flyingperson23/Booster-TC/info.txt

comp3 is ocd, sets flag on trigger
comp1 rising edge, resets output sync timer (pwm triggers before new rising edge)
comp2 both edges, resets measure timer (input capture, on interrupt set output sync timer ccr to 2*measure timer ccr - val, set output pwm arr=2*ccr, pulse=ccr)
output pwm timer resets on output sync timer trigger

output pwm = tim8
output sync timer = tim2
input measure timer = tim1

tim3 = lights pwm
comp6 = ac sync
adc1 = therm
tim20 = scr
tim7 = led pulse
tim6 = background loop

adc2, adc4 = vac, i_l
adc5 = vbus
comp7/dac2 = triggers on inductor overcurrent
comp3/dac3 triggers on primary overcurrent

background tasks:
cfg scr/boost
measure therm
set leds

new::
tim1 input capture and pwm
comp1 has no int, just measures + resets
on input capture trigger, measure if comp1 is high or low
if low, we got first half pulse - set pwm arr = 2*measured, ccr = 2*measured-delay
also set output pwm ccr=measured, arr=2*measured
on pwm trigger, hardware reset output and software write gdt disable pins
