flyingperson23/Booster-TC/hardware/booster-tc-driver-v2/booster-tc-driver.csv

Id | Designator | Footprint | Quantity | Designation | Supplier and ref
1 | SW1 | B12JV | 1 | SW_SPDT
2 | U3,U1 | IF-D95 | 2 | IF-D95T << must be T
3 | U2 | IF-E96E | 1 | IF-E96E
4 | J9,J3,J10 | PinHeader_1x2_P2.54mm_Drill1.02mm | 3 | 22-23-2021
5 | J7,J8,J6,J4,J5 | 36471662 | 5 | 3-647166-2
6 | C60,C61 | C_1206_3216Metric_Pad1.33x1.80mm_HandSolder | 2 | 1u C1206C105K5RACTU
7 | C19 | 860020575013 | 1 | 330u 860020575013
8 | C37,C29 | CAPPRD350W52D800H1300 | 2 | 470u 860020474014
9 | U5 | LQFP-48_7x7mm_P0.5mm | 1 | STM32G474CBTx
10 | J11 | CNC_3220-10-0300-00 | 1 | 3220-10-0300-00
11 | D11 | LED_5700100132F | 1 | 5700100132F
12 | U13,U12,U11,U10 | SQJ500AEP-T1_GE3_VIS | 4 | SQJ500AEP-T1_GE3
13 | C59,C58 | C_1210_3225Metric_Pad1.33x2.70mm_HandSolder | 2 | 2u2 C3225X7R1H225K250AB
14 | J2 | SAMTEC_EHT-105-01-S-D | 1 | EHT-105-01-S-D
15 | R29,R28 | R_1210_3225Metric_Pad1.30x2.65mm_HandSolder | 2 | 15R CRCW121015R0JNEAHP
16 | D19,D9,D17,D8,D1,D15,D2,D20,D7,D5,D3,D6,D4,D18,D10 | SOD-123 | 15 | 1N5819HW-7-F
17 | R21,R8,R11,R2,R25,R10,R4,R5,R7,R26,R24,R17,R27,R9,R1 | R_0603_1608Metric_Pad0.98x0.95mm_HandSolder | 15 | 1k
18 | D14 | DO-214AA | 1 | SMBJ3V3
19 | C36,C15,C25,C20,C26,C18,C46,C39,C41,C38,C40,C14,C47,C45,C53,C30,C49,C17,C28,C27,C22,C10,C23,C21,C16,C33,C52,C42 | C_0603_1608Metric_Pad1.08x0.95mm_HandSolder | 28 | .1uf
20 | C12,C11,C24 | C_0603_1608Metric_Pad1.08x0.95mm_HandSolder | 3 | 10n
21 | R16,R15 | R_0603_1608Metric_Pad0.98x0.95mm_HandSolder | 2 | 10k
22 | C9,C6 | C_0603_1608Metric_Pad1.08x0.95mm_HandSolder | 2 | 1u
23 | C55,C57,C54,C56 | C_1206_3216Metric_Pad1.33x1.80mm_HandSolder | 4 | .1uf 885012208087
24 | C34,C43,C51,C44,C50,C35,C4,C48,C1 | C_0603_1608Metric_Pad1.08x0.95mm_HandSolder | 9 | 2u2
25 | U6 | SOT-23 | 1 | MCP9700Ax-ETT
26 | C31,C8,C3,C2 | C_0603_1608Metric_Pad1.08x0.95mm_HandSolder | 4 | 1n
27 | R20 | R_0603_1608Metric_Pad0.98x0.95mm_HandSolder | 1 | 9k
28 | L4 | IND_ACM7060_TDK | 1 | ACM7060-701-2PL-TL01
29 | U7 | TO-263-5_TabPin3 | 1 | AP1501A-12K5G-13
30 | C5,C7 | C_0603_1608Metric_Pad1.08x0.95mm_HandSolder | 2 | 150p
31 | IC4,IC5 | SOIC127P600X175-8N | 2 | UCC27524AQDRQ1
32 | U9 | SOIC-8-1EP_3.9x4.9mm_P1.27mm_EP2.29x3mm | 1 | AOZ1284PI
33 | L2 | LQM2MPN4R7NG0L | 1 | 4u7 LQM2MPN4R7NG0L
34 | R12,R14,R13 | R_0603_1608Metric_Pad0.98x0.95mm_HandSolder | 3 | 24k9
35 | IC1 | CAT4109V-GT2 | 1 | CAT4109V-GT2
36 | R6 | R_2512_6332Metric_Pad1.40x3.35mm_HandSolder | 1 | 2R2 35222R2JT
37 | D16,D12 | D_SOD-128 | 2 | PMEG4050EP
38 | R3 | R_0603_1608Metric_Pad0.98x0.95mm_HandSolder | 1 | 150R
39 | R19 | R_0603_1608Metric_Pad0.98x0.95mm_HandSolder | 1 | 470k
40 | IC2 | SOT230P700X180-4N | 1 | LDL1117S50R
41 | Q1 | SOT-23 | 1 | T2N7002AK
42 | IC3 | SOT65P280X145-8N | 1 | AD5160BRJZ5-RL7
43 | D13 | DO-214AA | 1 | SMBJ5.0A-TR
44 | U4 | CSTNE16M0V530000R0 | 1 | CSTNE8M00G550000R0
45 | R18 | R_0603_1608Metric_Pad0.98x0.95mm_HandSolder | 1 | 47k
46 | R22 | R_0603_1608Metric_Pad0.98x0.95mm_HandSolder | 1 | 3k
47 | R23 | R_0603_1608Metric_Pad0.98x0.95mm_HandSolder | 1 | 82k
48 | C32 | C_0603_1608Metric_Pad1.08x0.95mm_HandSolder | 1 | 22n
49 | L1,L3 | IND_IHLP-3232DZ_VIS-M | 2 | 22u IHLP3232DZER220M5A
50 | U8 | SOT-223-3_TabPin2 | 1 | LT1963AxST-3.3
