flyingperson23/Booster-TC/hardware/booster-tc-driver-v3/booster-tc-driver.kicad_pcb

## KiCad design hardware/booster-tc-driver-v3/booster-tc-driver.kicad_pcb (2025-09-02)

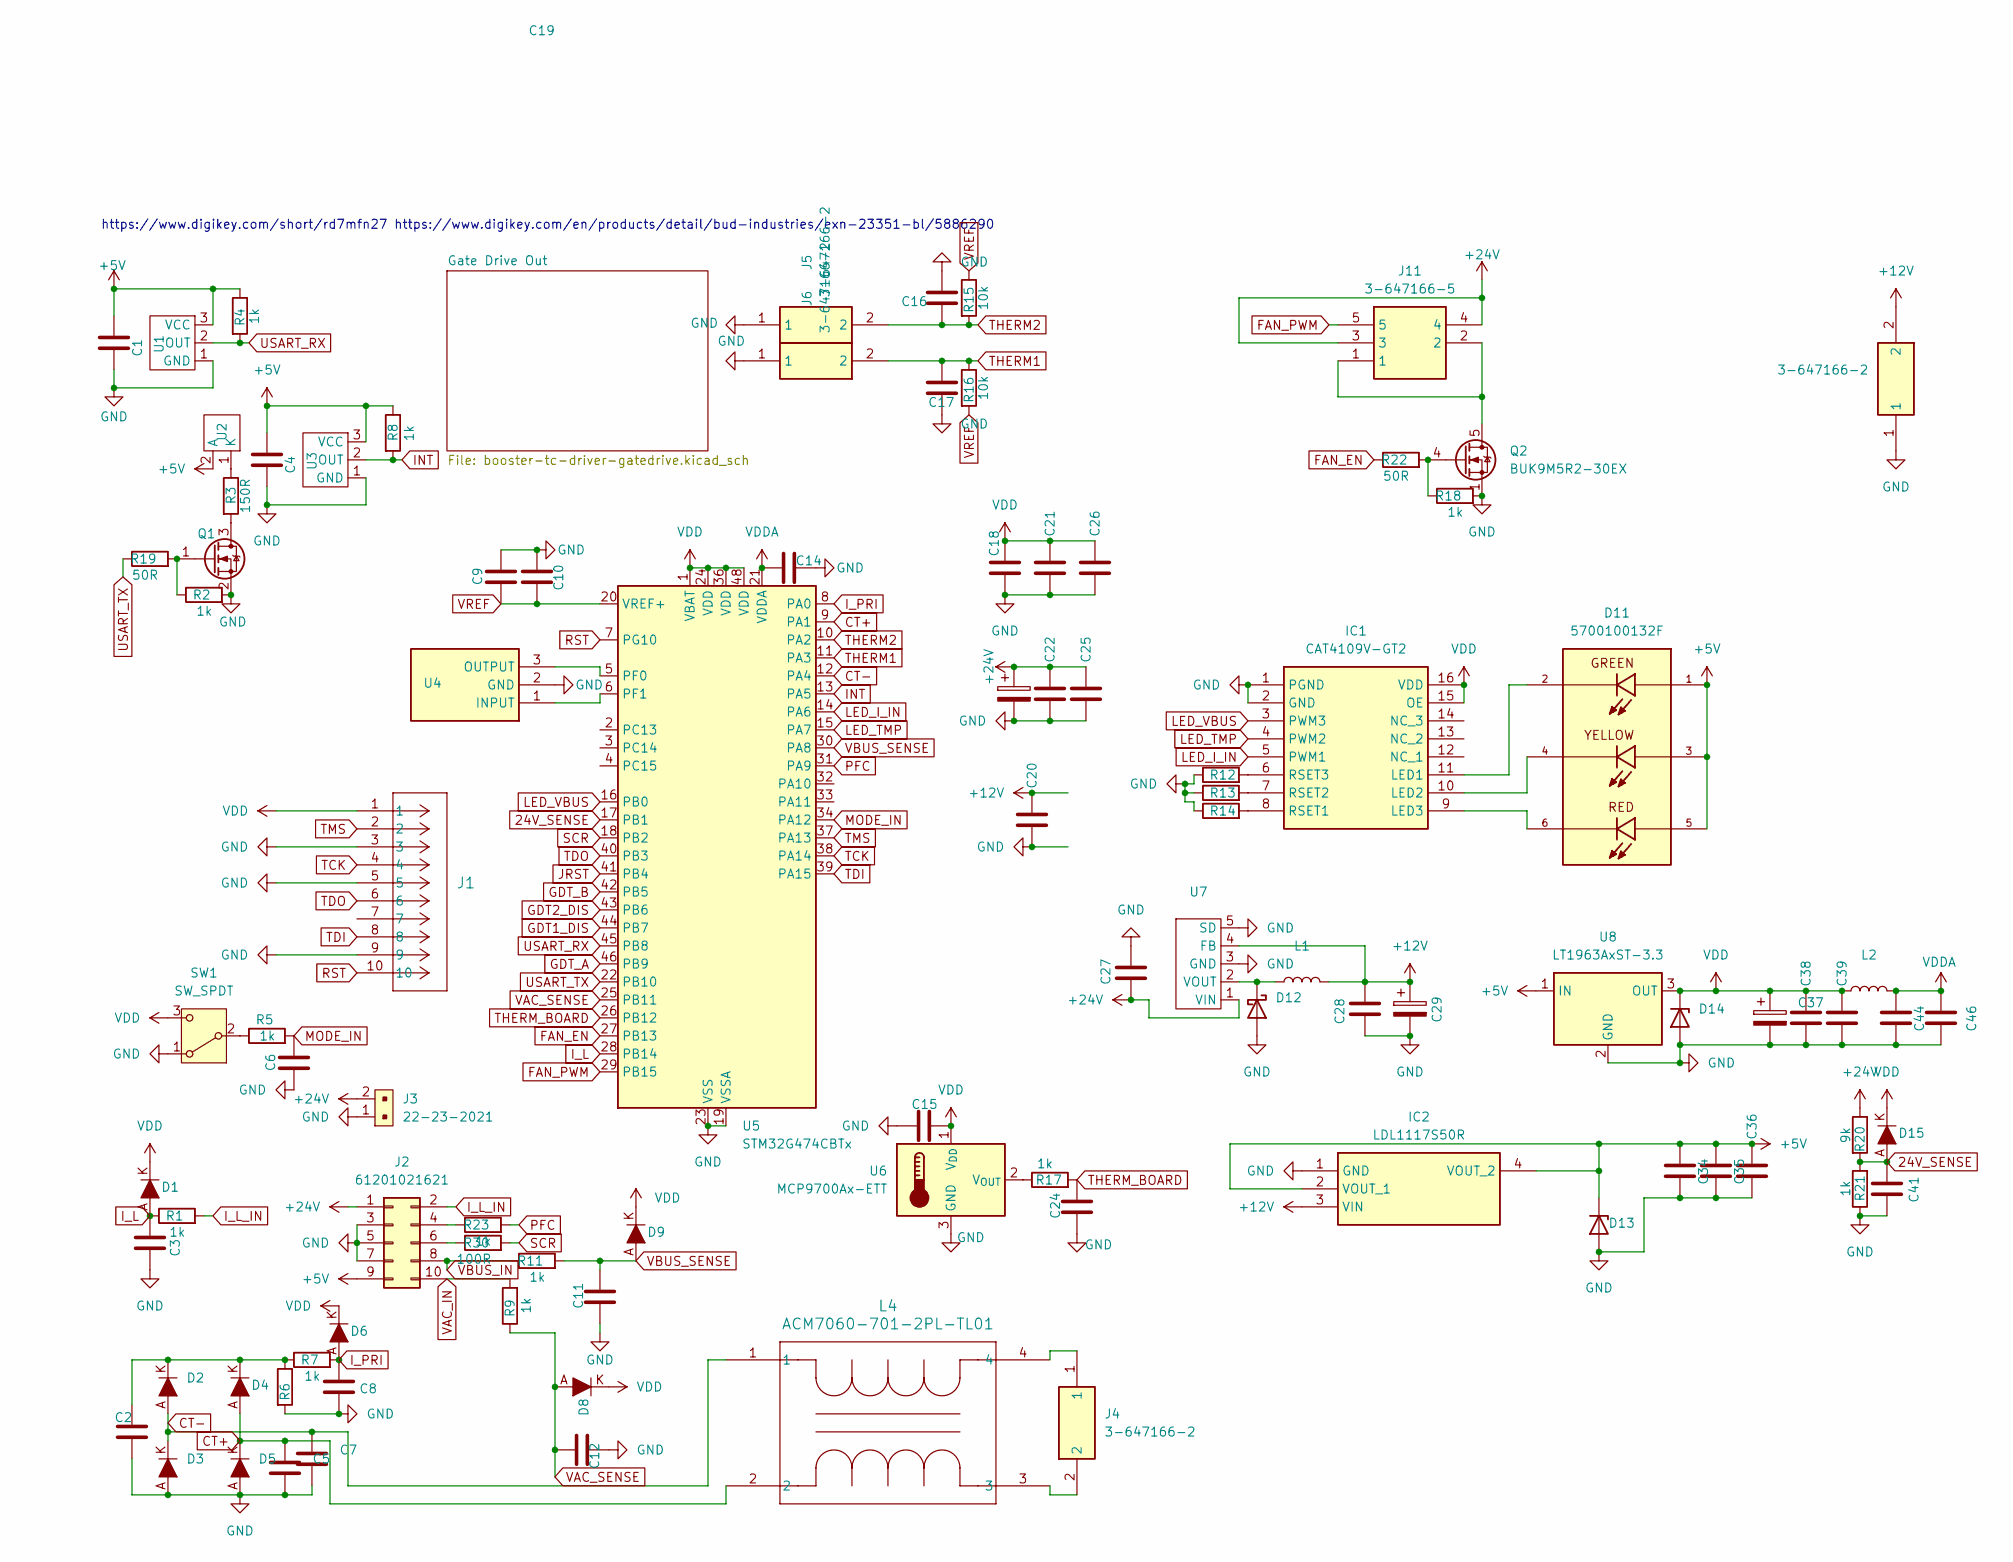
[picture p1: schematic booster-tc-driver.kicad_sch]

Parts:
C1, C4, C6, C9, C34, C35, C44: 2u2; C_0603_1608Metric_Pad1.08x0.95mm_HandSolder
C2, C3, C8: 1n; C_0603_1608Metric_Pad1.08x0.95mm_HandSolder
C5, C7: 150p; C_0603_1608Metric_Pad1.08x0.95mm_HandSolder
C10, C14, C15, C16, C17, C18, C20, C21, C22, C25, C26, C27, C28, C36, C38, C39, C41, C46: .1uf; C_0603_1608Metric_Pad1.08x0.95mm_HandSolder
C11, C12, C24: 10n; C_0603_1608Metric_Pad1.08x0.95mm_HandSolder
C19: 330u 860020575013; 860020575013
C29, C37: 470u 860020474014; CAPPRD350W52D800H1300
D1, D2, D3, D4, D5, D6, D8, D9, D15: 1N5819HW-7-F; SOD-123; MPN 1N5819HW-7-F
D11: 5700100132F; LED_5700100132F; PARTREV N
D12: PMEG4050EP; D_SOD-128
D13: SMBJ5.0A-TR; DO-214AA
D14: SMBJ3V3; DO-214AA
IC1: CAT4109V-GT2; Mouser Part Number 698-CAT4109V-GT2
IC2: LDL1117S50R; SOT230P700X180-4N; Mouser Part Number 511-LDL1117S50R
J1: 62201021121; CONN_62201021121_WRE
J2: 61201021621; IDC-Header_2x05_P2.54mm_Vertical
J3: 22-23-2021; PinHeader_1x2_P2.54mm_Drill1.02mm; MPN 22-23-2021
J4, J5, J6, J7: 3-647166-2; 36471662; Mouser Part Number 571-3-647166-2
J11: 3-647166-5; 36471665; Mouser Part Number 571-3-647166-5
L1: 22u IHLP3232DZER220M5A; IND_IHLP-3232DZ_VIS-M
L2: 4u7 LQM2MPN4R7NG0L; LQM2MPN4R7NG0L
L4: ACM7060-701-2PL-TL01; IND_ACM7060_TDK
Q1: T2N7002AK; SOT-23
Q2: BUK9M5R2-30EX; LFPAK33
R1, R2, R4, R5, R7, R8, R9, R11, R17, R18, R21, R23: 1k; R_0603_1608Metric_Pad0.98x0.95mm_HandSolder
R3: 150R; R_0603_1608Metric_Pad0.98x0.95mm_HandSolder
R6: 2R2 35222R2JT; R_2512_6332Metric_Pad1.40x3.35mm_HandSolder
R12, R13, R14: 24k9; R_0603_1608Metric_Pad0.98x0.95mm_HandSolder
R15, R16: 10k; R_0603_1608Metric_Pad0.98x0.95mm_HandSolder
R19, R22: 50R; R_0603_1608Metric_Pad0.98x0.95mm_HandSolder
R20: 9k; R_0603_1608Metric_Pad0.98x0.95mm_HandSolder
R30: 100R; R_0603_1608Metric_Pad0.98x0.95mm_HandSolder
SW1: SW_SPDT; B12JV
U1, U3: IF-D95T << must be T; IF-D95
U2: IF-E96E
U4: CSTNE8M00G550000R0; CSTNE16M0V530000R0; Mouser Part Number 81-CSTNE8M00G550000R
U5: STM32G474CBTx; LQFP-48_7x7mm_P0.5mm
U6: MCP9700Ax-ETT; SOT-23
U7: AP1501A-12K5G-13; TO-263-5_TabPin3
U8: LT1963AxST-3.3; SOT-223-3_TabPin2

Connections:
24V_SENSE: C41.1, D15.A, R20.2, R21.2, U5.17 (PB1)
+5V: C1.1, C4.1, C34.1, C35.1, C36.1, D11.1, D11.3, D11.5, D13.1 (K), IC2.2 (VOUT_1), IC2.4 (VOUT_2), J2.9, R4.1, R8.1, U1.3 (VCC), U2.2 (A), U3.3 (VCC), U8.1 (IN)
+12V: C20.1, C28.1, C29.1, IC2.3 (VIN), J7.2, L1.2, U7.4 (FB); also elsewhere on the board
+24V: C19.1, C22.1, C25.1, C27.2, J2.1, J3.2, J11.3, J11.4, R20.1, U7.1 (VIN); also elsewhere on the board
CT+: C5.1, D4.A, D5.K, L4.2, U5.9 (PA1)
CT-: C7.1, D2.A, D3.K, L4.1, U5.12 (PA4)
FAN_EN: R22.1, U5.27 (PB13)
FAN_PWM: J11.5, U5.29 (PB15)
GDT1_DIS: U5.44 (PB7); also elsewhere on the board
GDT2_DIS: U5.43 (PB6); also elsewhere on the board
GDT_A: U5.46 (PB9); also elsewhere on the board
GDT_B: U5.42 (PB5); also elsewhere on the board
GND: C1.2, C2.2, C3.2, C4.2, C5.2, C6.2, C7.2, C8.2, C9.1, C10.1, C11.2, C12.2, C14.2, C15.1, C16.2, C17.1, C18.2, C19.2, C20.2, C21.2, C22.2, C24.2, C25.2, C26.2, C27.1, C28.2, C29.2, C34.2, C35.2, C36.2, C37.2, C38.2, C39.2, C41.2, C44.2, C46.2, D3.A, D5.A, D12.2 (A), D13.2 (A), D14.2 (A), IC1.1 (PGND), IC1.2 (GND), IC2.1 (GND), J1.3, J1.5, J1.9, J2.3, J2.5, J2.7, J3.1, J5.1, J6.1, J7.1, Q1.2 (S), Q2.1 (S), Q2.2 (S), Q2.3 (S), R2.2, R6.2, R12.1, R13.1, R14.1, R18.2, R21.1, SW1.1 (A), U1.1 (GND), U3.1 (GND), U4.2 (GND), U5.19 (VSSA), U5.23 (VSS), U5.35 (VSS), U5.47 (VSS), U6.3 (GND), U7.3 (GND), U7.5 (SD), U8.2 (GND); also elsewhere on the board
INT: R8.2, U3.2 (OUT), U5.13 (PA5)
I_L: C3.1, D1.A, R1.1, U5.28 (PB14)
I_L_IN: J2.2, R1.2
I_PRI: C8.1, D6.A, R7.2, U5.8 (PA0)
JRST: U5.41 (PB4)
LED_I_IN: IC1.5 (PWM1), U5.14 (PA6)
LED_TMP: IC1.4 (PWM2), U5.15 (PA7)
LED_VBUS: IC1.3 (PWM3), U5.16 (PB0)
MODE_IN: C6.1, R5.2, U5.34 (PA12)
unnamed: C2.1, D2.K, D4.K, R6.1, R7.1
unnamed: D12.1 (K), L1.1, U7.2 (VOUT)
unnamed: D11.2, IC1.11 (LED1)
unnamed: D11.4, IC1.10 (LED2)
unnamed: D11.6, IC1.9 (LED3)
unnamed: IC1.8 (RSET1), R14.2
unnamed: IC1.7 (RSET2), R13.2
unnamed: IC1.6 (RSET3), R12.2
unnamed: J2.4, R23.1
unnamed: J2.6, R30.1
unnamed: J4.1, L4.4
unnamed: J4.2, L4.3
unnamed: Q1.3 (D), R3.2
unnamed: Q1.1 (G), R2.1, R19.2
unnamed: J11.1, J11.2, Q2.5 (D)
unnamed: Q2.4 (G), R18.1, R22.2
unnamed: R5.1, SW1.2 (B)
unnamed: R3.1, U2.1 (K)
unnamed: U4.1 (INPUT), U5.6 (PF1)
unnamed: U4.3 (OUTPUT), U5.5 (PF0)
unnamed: R17.1, U6.2 (V_{OUT})
PFC: R23.2, U5.31 (PA9)
RST: J1.10, U5.7 (PG10)
SCR: R30.2, U5.18 (PB2)
TCK: J1.4, U5.38 (PA14)
TDI: J1.8, U5.39 (PA15)
TDO: J1.6, U5.40 (PB3)
THERM1: C17.2, J6.2, R16.1, U5.11 (PA3)
THERM2: C16.1, J5.2, R15.2, U5.10 (PA2)
THERM_BOARD: C24.1, R17.2, U5.26 (PB12)
TMS: J1.2, U5.37 (PA13)
USART_RX: R4.2, U1.2 (OUT), U5.45 (PB8)
USART_TX: R19.1, U5.22 (PB10)
VAC_IN: J2.10, R9.2
VAC_SENSE: C12.1, D8.A, R9.1, U5.25 (PB11)
VBUS_IN: J2.8, R11.1
VBUS_SENSE: C11.1, D9.A, R11.2, U5.30 (PA8)
VDD: C15.2, C18.1, C21.1, C26.1, C37.1, C38.1, C39.1, D1.K, D6.K, D8.K, D9.K, D14.1 (K), D15.K, IC1.15 (OE), IC1.16 (VDD), J1.1, L2.1, SW1.3 (C), U5.1 (VBAT), U5.24 (VDD), U5.36 (VDD), U5.48 (VDD), U6.1 (V_{DD}), U8.3 (OUT)
VDDA: C14.1, C44.1, C46.1, L2.2, U5.21 (VDDA)
VREF: C9.2, C10.2, R15.1, R16.2, U5.20 (VREF+)

Notes on the sheet:
https://www.digikey.com/short/rd7mfn27 https://www.digikey.com/en/products/detail/bud-industries/exn-23351-bl/5886290

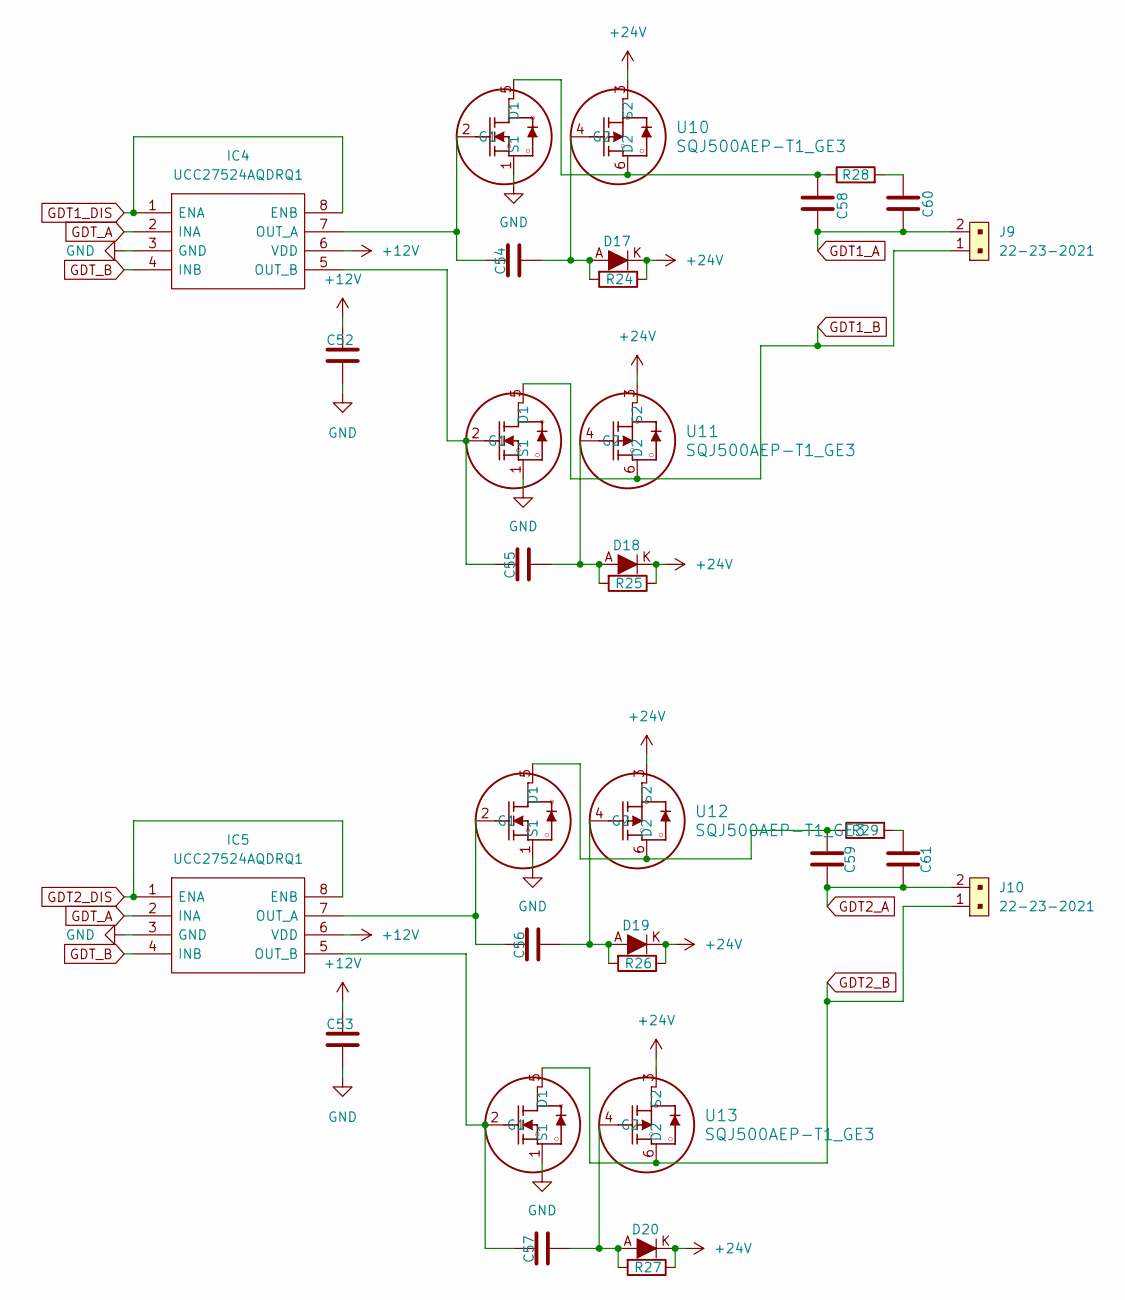
[picture p2: schematic booster-tc-driver-gatedrive.kicad_sch]

Parts:
C52, C53: .1uf; C_0603_1608Metric_Pad1.08x0.95mm_HandSolder
C54, C55, C56, C57: .1uf 885012208087; C_1206_3216Metric_Pad1.33x1.80mm_HandSolder
C58, C59: 2u2 C3225X7R1H225K250AB; C_1210_3225Metric_Pad1.33x2.70mm_HandSolder
C60, C61: 1u C1206C105K5RACTU; C_1206_3216Metric_Pad1.33x1.80mm_HandSolder
D17, D18, D19, D20: 1N5819HW-7-F; SOD-123; MPN 1N5819HW-7-F
IC4, IC5: UCC27524AQDRQ1; SOIC127P600X175-8N; Mouser Part Number 595-UCC27524AQDRQ1
J9, J10: 22-23-2021; PinHeader_1x2_P2.54mm_Drill1.02mm; MPN 22-23-2021
R24, R25, R26, R27: 1k; R_0603_1608Metric_Pad0.98x0.95mm_HandSolder
R28, R29: 15R CRCW121015R0JNEAHP; R_1210_3225Metric_Pad1.30x2.65mm_HandSolder
U10, U11, U12, U13: SQJ500AEP-T1_GE3; SQJ500AEP-T1_GE3_VIS

Connections:
+12V: C52.1, C53.1, IC4.6 (VDD), IC5.6 (VDD); also elsewhere on the board
+24V: D17.K, D18.K, D19.K, D20.K, R24.1, R25.1, R26.1, R27.1, U10.3 (S2), U11.3 (S2), U12.3 (S2), U13.3 (S2); also elsewhere on the board
GDT1_A: C58.2, C60.2, J9.2
GDT1_B: J9.1, U11.5 (D1), U11.6 (D2)
GDT1_DIS: IC4.1 (ENA), IC4.8 (ENB); also elsewhere on the board
GDT2_A: C59.2, C61.2, J10.2
GDT2_B: J10.1, U13.5 (D1), U13.6 (D2)
GDT2_DIS: IC5.1 (ENA), IC5.8 (ENB); also elsewhere on the board
GDT_A: IC4.2 (INA), IC5.2 (INA); also elsewhere on the board
GDT_B: IC4.4 (INB), IC5.4 (INB); also elsewhere on the board
GND: C52.2, C53.2, IC4.3 (GND), IC5.3 (GND), U10.1 (S1), U11.1 (S1), U12.1 (S1), U13.1 (S1); also elsewhere on the board
unnamed: C60.1, R28.2
unnamed: C61.1, R29.2
unnamed: C54.1, IC4.7 (OUT_A), U10.2 (G1)
unnamed: C55.1, IC4.5 (OUT_B), U11.2 (G1)
unnamed: C56.1, IC5.7 (OUT_A), U12.2 (G1)
unnamed: C57.1, IC5.5 (OUT_B), U13.2 (G1)
unnamed: C58.1, R28.1, U10.5 (D1), U10.6 (D2)
unnamed: C54.2, D17.A, R24.2, U10.4 (G2)
unnamed: C55.2, D18.A, R25.2, U11.4 (G2)
unnamed: C59.1, R29.1, U12.5 (D1), U12.6 (D2)
unnamed: C56.2, D19.A, R26.2, U12.4 (G2)
unnamed: C57.2, D20.A, R27.2, U13.4 (G2)

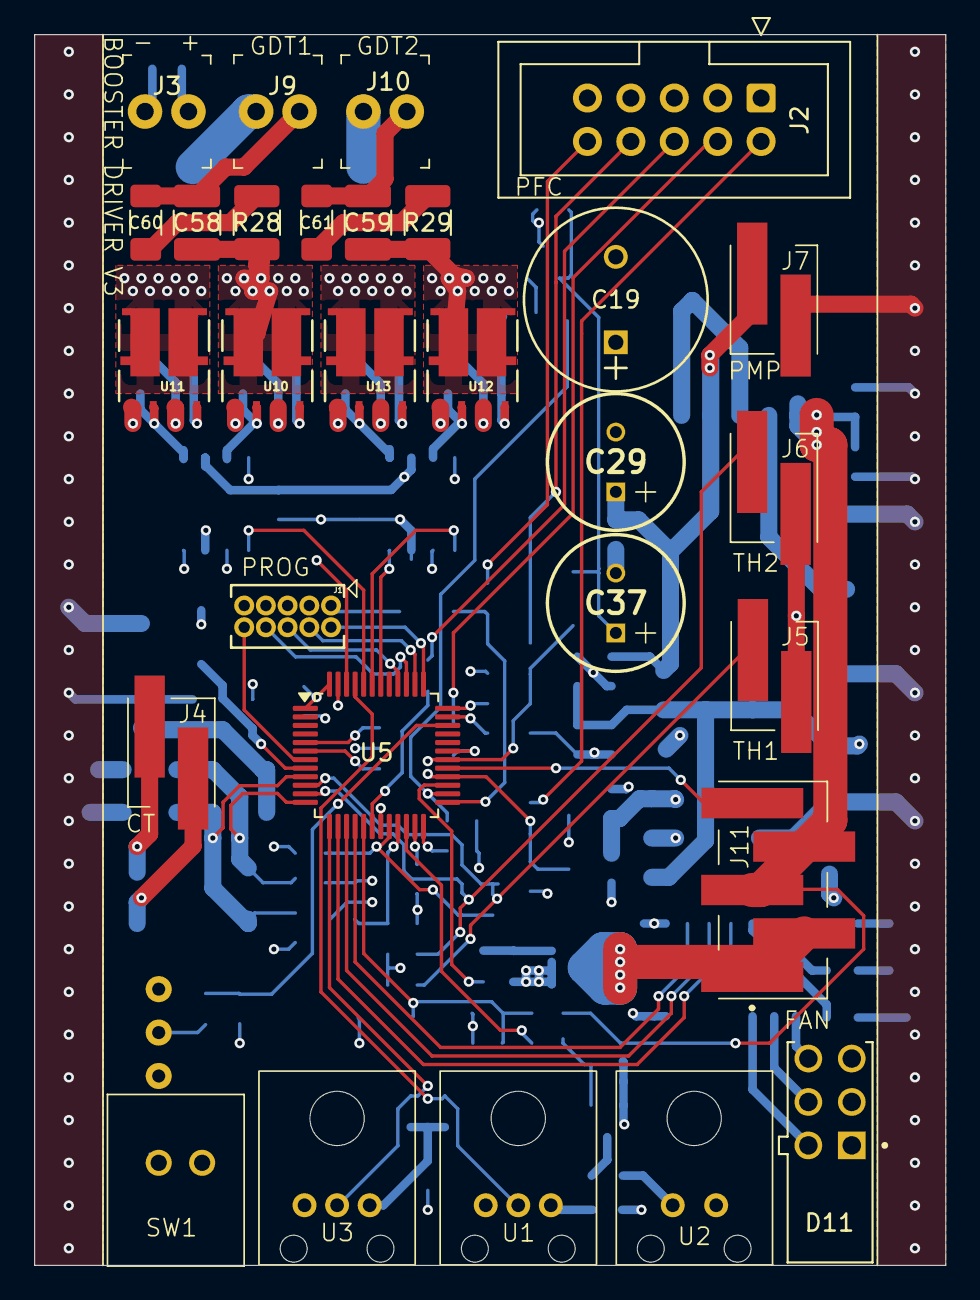
[picture p3: board hardware/booster-tc-driver-v3/booster-tc-driver.kicad_pcb from above]

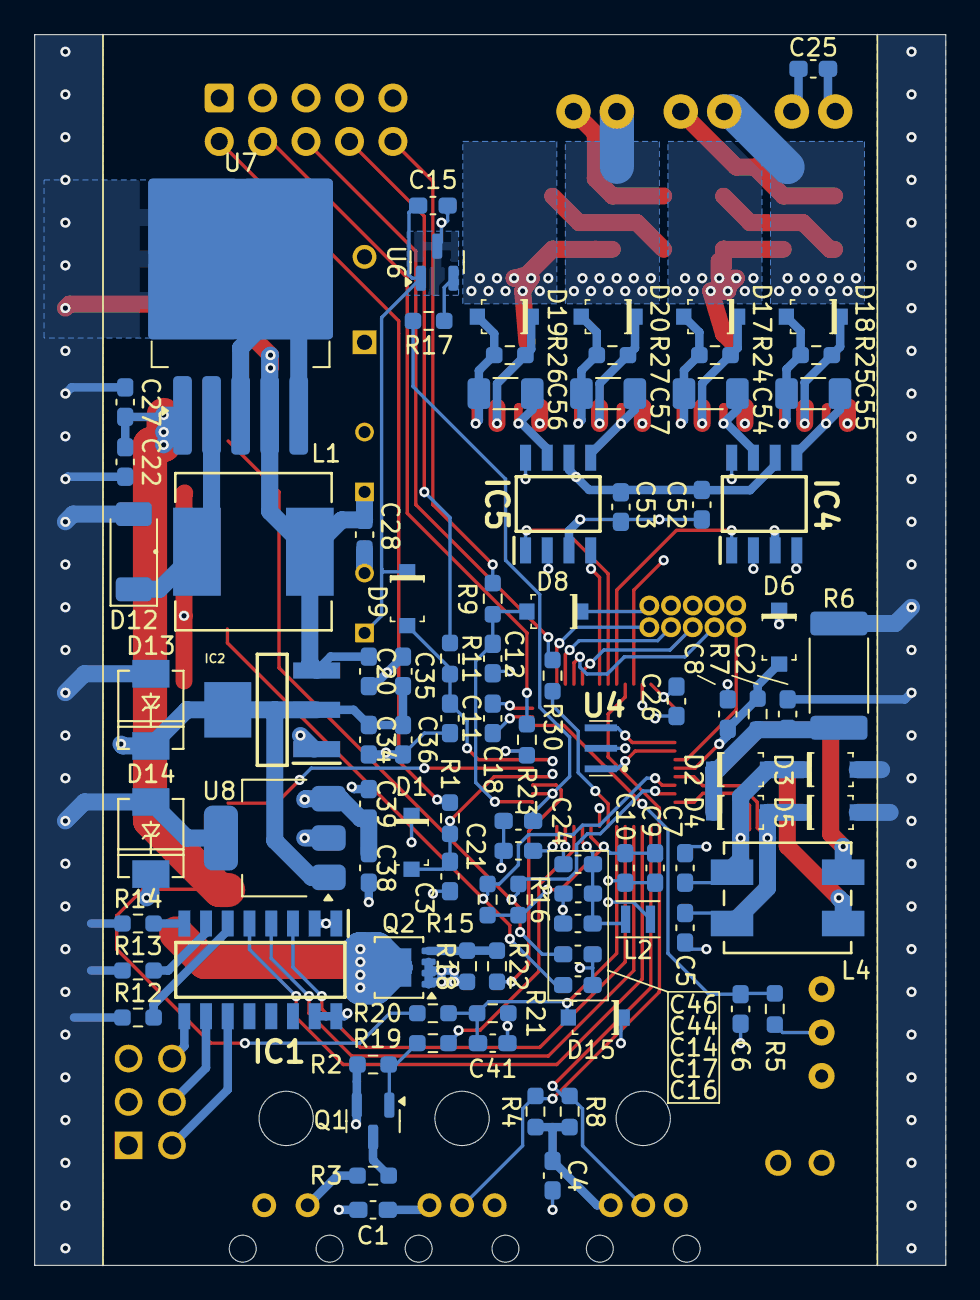
[picture p4: board hardware/booster-tc-driver-v3/booster-tc-driver.kicad_pcb from below]

Board: 4 copper layers, 53.3 x 72.0 mm, 124 parts (95 on the bottom side), 77 nets.
