flyingperson23/Booster-TC/hardware/booster-pfc-v4/booster-pfc-v4.kicad_pcb

## KiCad design hardware/booster-pfc-v4/booster-pfc-v4.kicad_pcb (2025-09-02)

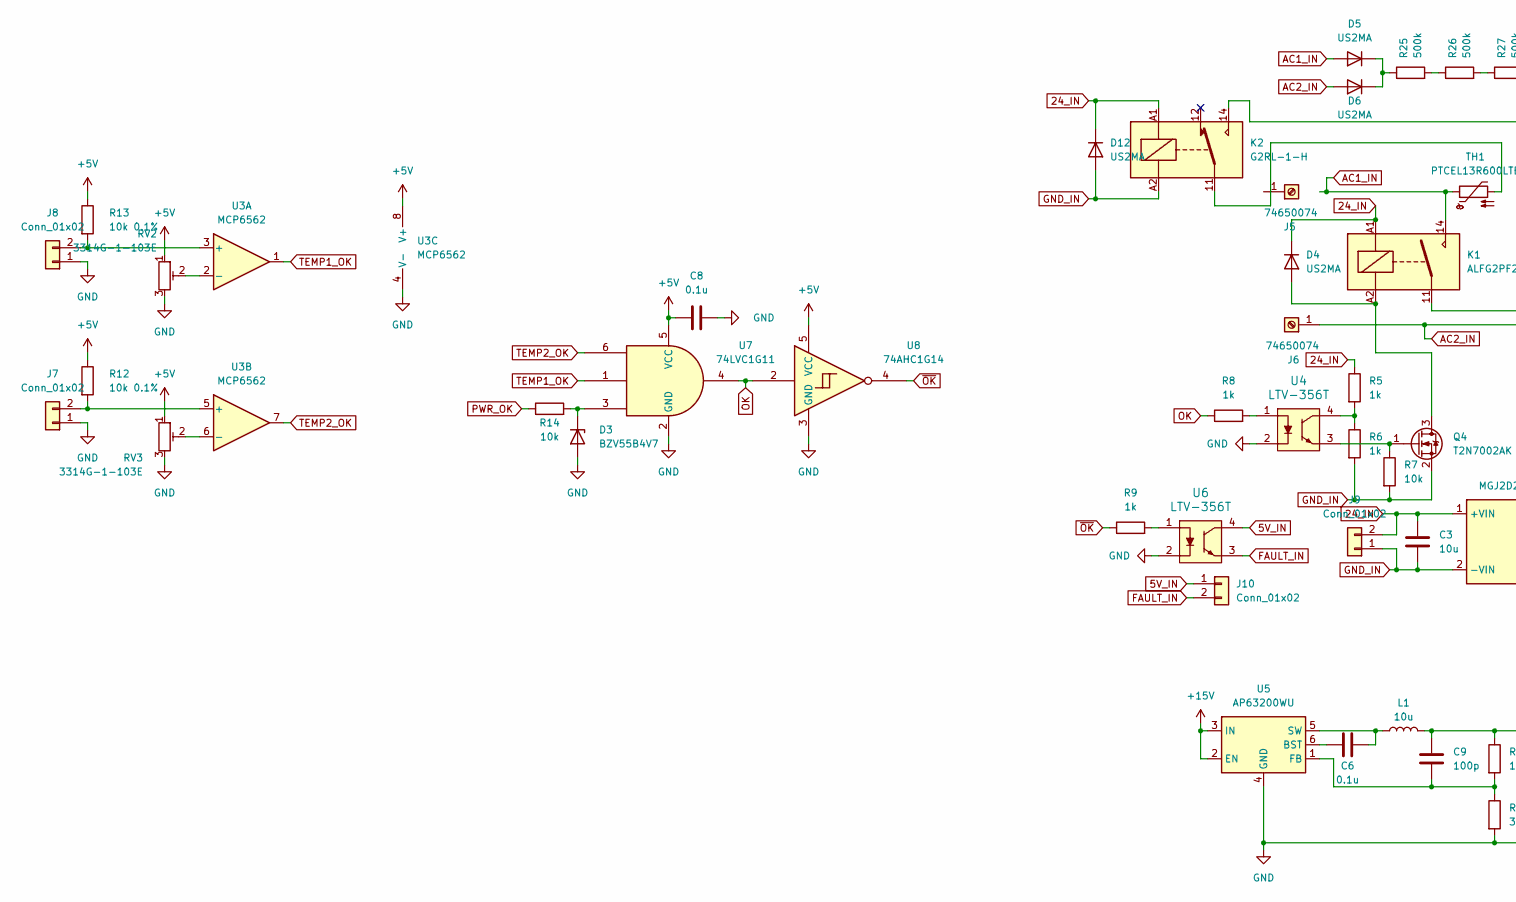
[picture p5: schematic booster-pfc-v4.kicad_sch, part in row 1, column 1]

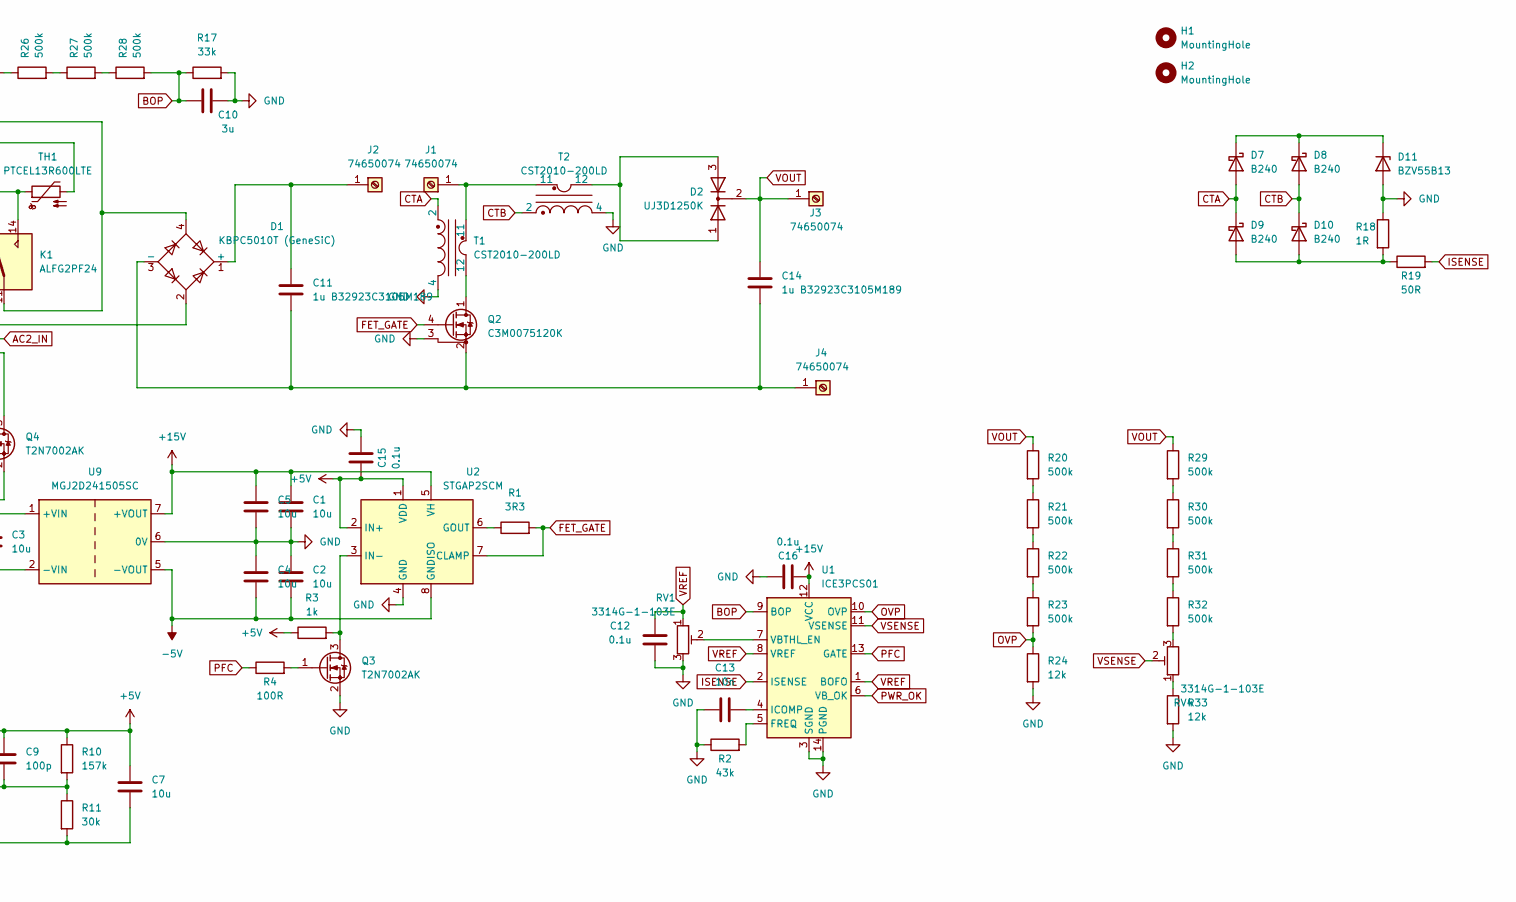
[picture p6: schematic booster-pfc-v4.kicad_sch, part in row 1, column 2]

Parts:
C1, C2, C3, C4, C5, C7: 10u; C_1206_3216Metric
C6, C12, C15, C16: 0.1u; C_0805_2012Metric
C8: 0.1u; C_1206_3216Metric
C9: 100p; C_0805_2012Metric
C10: 3u; C_0805_2012Metric
C11, C14: 1u B32923C3105M189; B32923C__26.5_x_12_
C13: 10n; C_0805_2012Metric
D1: KBPC5010T (GeneSiC); DrillHole_Diode_Bridge_GeneSiC_KBPC_T
D2: UJ3D1250K; TO-247-3_Horizontal_TabDown
D3: BZV55B4V7; D_MiniMELF
D4, D5, D6, D12: US2MA; D_SMA
D7, D8, D9, D10: B240; D_SMB
D11: BZV55B13; D_MiniMELF
H1, H2: MountingHole; MountingHole_4.3mm_M4
J1, J2, J3, J4, J5, J6: 74650074; Wuerth_REDCUBE-THR_WP-THRBU_74650074_THR
J7, J8, J9, J10: Conn_01x02; Molex_KK-254_AE-6410-02A_1x02_P2.54mm_Vertical
K1: ALFG2PF24; Relay_SPST_Panasonic_ALFG_FormA_CircularHoles
K2: G2RL-1-H; Relay_SPDT_Omron_G2RL-1
L1: 10u; L_Bourns_SRP7028A_7.3x6.6mm; MPN SRP7028A-100M
Q2: C3M0075120K; TO-247-4_Horizontal_TabDown
Q3, Q4: T2N7002AK; SOT-23
R1: 3R3; R_0805_2012Metric
R2: 43k; R_0805_2012Metric
R3, R5, R6, R8, R9: 1k; R_0805_2012Metric
R4: 100R; R_0805_2012Metric
R7, R14: 10k; R_0805_2012Metric
R10: 157k; R_0805_2012Metric
R11: 30k; R_0805_2012Metric
R12, R13: 10k 0.1%; R_0805_2012Metric
R17: 33k; R_0805_2012Metric
R18: 1R; R_0805_2012Metric
R19: 50R; R_0805_2012Metric
R20, R21, R22, R23, R25, R26, R27, R28, R29, R30, R31, R32: 500k; R_0805_2012Metric
R24, R33: 12k; R_0805_2012Metric
RV1, RV2, RV3, RV4: 3314G-1-103E; Potentiometer_Bourns_3314G_Vertical
T1, T2: CST2010-200LD; Transformer_Coilcraft_CST2010
TH1: PTCEL13R600LTE; THERMISTOR_PTCEL13_5MM_VIS
U1: ICE3PCS01; SOIC-14_3.9x8.7mm_P1.27mm
U2: STGAP2SCM; SOIC-8_3.9x4.9mm_P1.27mm
U3: MCP6562; SOIC-8_3.9x4.9mm_P1.27mm
U4, U6: LTV-356T; SMD-4_4.4x3.85mm_P2.54mm; MPN LTV-356T; Digi-Key_PN 160-1337-1-ND
U5: AP63200WU; TSOT-23-6
U7: 74LVC1G11; SOT-23-6
U8: 74AHC1G14; SOT-23-5
U9: MGJ2D241505SC; Converter_DCDC_Murata_MGJ2DxxxxxxSC_THT

Connections:
5V_IN: J10.1, U6.4
24_IN: C3.1, D4.1 (K), D12.1 (K), J9.2, K1.A1, K2.A1, R5.1, U9.1 (+VIN)
+5V: C7.1, C8.1, C9.1, C15.2, L1.2, R3.1, R10.1, R12.1, R13.1, RV2.1, RV3.1, U2.1 (VDD), U2.2 (IN+), U3.8 (V+), U7.5 (VCC), U8.5 (VCC)
+15V: C1.1, C5.1, C16.2, U1.12 (VCC), U2.5 (VH), U5.2 (EN), U5.3 (IN), U9.7 (+VOUT)
-5V: C2.2, C4.2, U2.8 (GNDISO), U9.5 (-VOUT)
AC1_IN: D5.2 (A), K1.14, TH1.1
AC2_IN: D1.2, D6.2 (A), J6.1
BOP: C10.1, R17.1, R28.2, U1.9 (BOP)
CTA: D7.2 (A), D9.1 (K), T1.2
CTB: D8.2 (A), D10.1 (K), T2.2
FAULT_IN: J10.2, U6.3
FET_GATE: Q2.4 (G), R1.2, U2.7 (CLAMP)
GND: C1.2, C2.1, C4.1, C5.2, C7.2, C8.2, C10.2, C12.1, C13.1, C15.1, C16.1, D3.2 (A), D11.2 (A), J7.1, J8.1, Q2.3 (DS), Q3.2 (S), R2.1, R11.2, R17.2, R18.1, R24.2, R33.2, RV1.3, RV2.3, RV3.3, T1.4, T2.4, U1.3 (SGND), U1.14 (PGND), U2.4 (GND), U3.4 (V-), U4.2, U5.4 (GND), U6.2, U7.2 (GND), U8.3 (GND), U9.6 (0V)
GND_IN: C3.2, D12.2 (A), J9.1, K2.A2, Q4.2 (S), R6.2, R7.2, U9.2 (-VIN)
ISENSE: R19.2, U1.2 (ISENSE)
unnamed: C11.1, D1.1 (+), J2.1
unnamed: C11.2, C14.2, D1.3 (-), J4.1, Q2.2 (S)
unnamed: D1.4, K1.11, K2.14
unnamed: D2.1 (A), D2.3 (A), T2.12
unnamed: D3.1 (K), R14.2, U7.3
unnamed: D4.2 (A), K1.A2, Q4.3 (D)
unnamed: D5.1 (K), D6.1 (K), R25.1
unnamed: D9.2 (A), D10.2 (A), R18.2, R19.1
unnamed: D7.1 (K), D8.1 (K), D11.1 (K)
unnamed: J1.1, T1.11, T2.11
unnamed: J7.2, R12.2, U3.5 (+)
unnamed: J8.2, R13.2, U3.3 (+)
unnamed: K2.11, TH1.2
unnamed: Q2.1 (D), T1.12
unnamed: Q3.3 (D), R3.2, U2.3 (IN-)
unnamed: Q3.1 (G), R4.2
unnamed: Q4.1 (G), R7.1, U4.3
unnamed: R5.2, R6.1, U4.4
unnamed: R8.2, U4.1
unnamed: R9.2, U6.1
unnamed: R20.2, R21.1
unnamed: R21.2, R22.1
unnamed: R22.2, R23.1
unnamed: R25.2, R26.1
unnamed: R26.2, R27.1
unnamed: R27.2, R28.1
unnamed: R29.2, R30.1
unnamed: R30.2, R31.1
unnamed: R31.2, R32.1
unnamed: R32.2, RV4.3
unnamed: R33.1, RV4.1
unnamed: R2.2, U1.5 (FREQ)
unnamed: C13.2, U1.4 (ICOMP)
unnamed: RV1.2, U1.7 (VBTHL_EN)
unnamed: R1.1, U2.6 (GOUT)
unnamed: RV2.2, U3.2 (-)
unnamed: RV3.2, U3.6 (-)
unnamed: C6.2, U5.6 (BST)
unnamed: C9.2, R10.2, R11.1, U5.1 (FB)
unnamed: C6.1, L1.1, U5.5 (SW)
OK: R8.1, U7.4, U8.2
OVP: R23.2, R24.1, U1.10 (OVP)
PFC: R4.1, U1.13 (GATE)
PWR_OK: R14.1, U1.6 (VB_OK)
TEMP1_OK: U3.1, U7.1
TEMP2_OK: U3.7, U7.6
VOUT: C14.1, D2.2 (K), J3.1, R20.1, R29.1
VREF: C12.2, RV1.1, U1.1 (BOFO), U1.8 (VREF)
VSENSE: RV4.2, U1.11 (VSENSE)
~OK: R9.1, U8.4

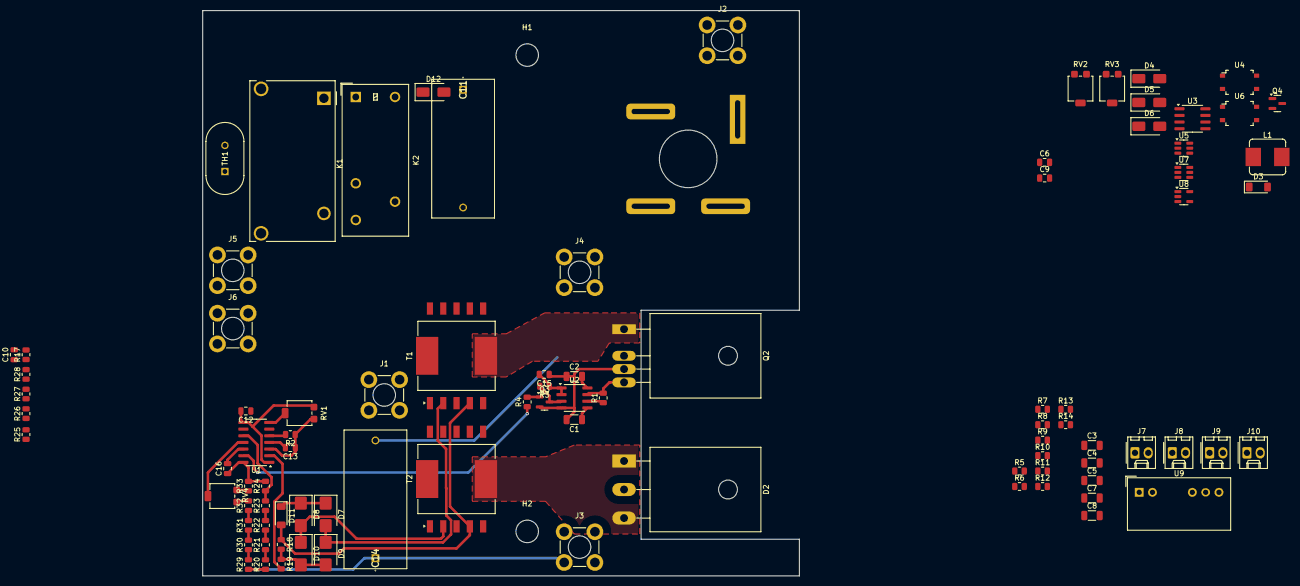
[picture p7: board booster-pfc-v4.kicad_pcb from above]

Board: 2 copper layers, 114.0 x 108.0 mm, 93 parts (1 on the bottom side), 65 nets.
