flyingperson23/Booster-TC/hardware/booster-pfc-v3/booster-tc.kicad_pcb

## KiCad design hardware/booster-pfc-v3/booster-tc.kicad_pcb (2025-09-02, an earlier design)

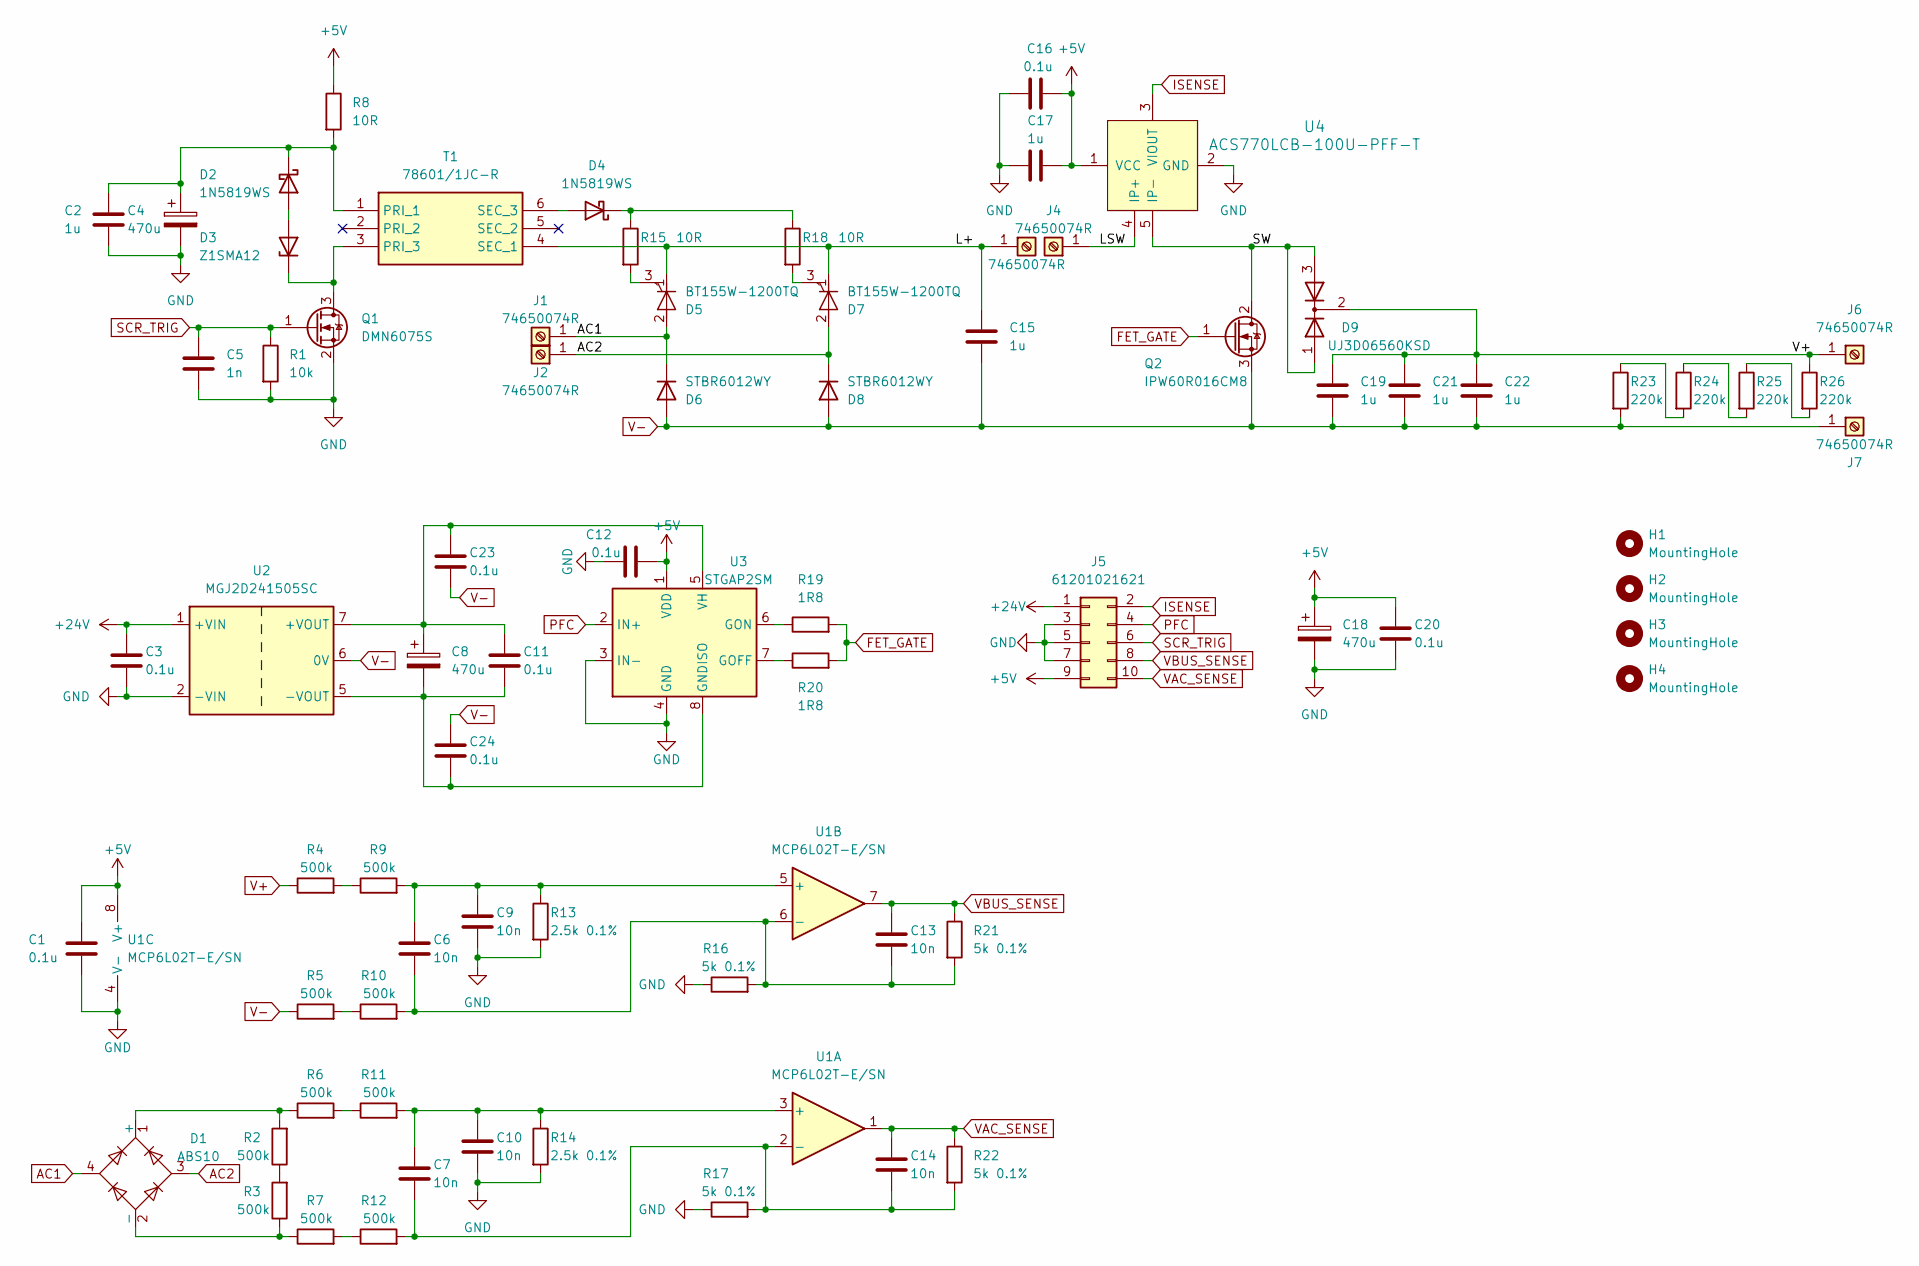
[picture p8: schematic booster-tc.kicad_sch]

Parts:
C1, C3, C11, C12, C16, C20, C23, C24: 0.1u; C_0805_2012Metric
C2, C17: 1u; C_0805_2012Metric
C4, C8, C18: 470u; CAPPRD350W52D800H1300; MPN 860020474014
C5: 1n; C_0805_2012Metric
C6, C7, C9, C10, C13, C14: 10n; C_0805_2012Metric
C15, C19, C21, C22: 1u; B32672P4105K000; MPN B32672P4105K000
D1: ABS10; Diode_Bridge_Diotec_ABS
D2, D4: 1N5819WS; D_SOD-323
D3: Z1SMA12; D_MicroMELF
D5, D7: BT155W-1200TQ; TO-247-3_Cutout
D6, D8: STBR6012WY; TO-247-2_Cutout
D9: UJ3D06560KSD; TO-247-3_Cutout
H1, H2, H3, H4: MountingHole; MountingHole_3.2mm_M3
J1, J2, J3, J4, J6, J7: 74650074R; Wuerth_REDCUBE-THR_WP-THRBU_74650074_THR
J5: 61201021621; IDC-Header_2x05_P2.54mm_Vertical
Q1: DMN6075S; SOT-23
Q2: IPW60R016CM8; TO-247-3_Cutout
R1: 10k; R_0805_2012Metric
R2, R3, R4, R5, R6, R7, R9, R10, R11, R12: 500k; R_0805_2012Metric
R8, R15, R18: 10R; R_0805_2012Metric
R13, R14: 2.5k 0.1%; R_0805_2012Metric
R16, R17, R21, R22: 5k 0.1%; R_0805_2012Metric
R19, R20: 1R8; R_0805_2012Metric
R23, R24, R25, R26: 220k; R_0805_2012Metric
T1: 78601/1JC-R; SOP254P1270X665-6N; Mouser Part Number 580-786019C
U1: MCP6L02T-E/SN; SOIC-8_3.9x4.9mm_P1.27mm
U2: MGJ2D241505SC; Converter_DCDC_Murata_MGJ2DxxxxxxSC_THT
U3: STGAP2SM; SOIC-8_3.9x4.9mm_P1.27mm
U4: ACS770LCB-100U-PFF-T; CB-5_Formed_Leads; MPN ACS770LCB-100U-PFF-T; Digi-Key_PN 620-1543-5-ND

Connections:
+5V: C1.1, C12.2, C16.2, C17.1, C18.1, C20.1, J5.9, R8.1, U1.8 (V+), U3.1 (VDD), U4.1 (VCC)
+24V: C3.1, J5.1, U2.1 (+VIN)
/L+: C15.1, D5.1 (K), D7.1 (K), J3.1, T1.4 (SEC_1)
/LSW: J4.1, U4.4 (IP+)
/SW: D9.1 (A), D9.3 (A), Q2.2 (D), U4.5 (IP-)
AC1: D1.4, D5.2 (A), D6.1 (K), J1.1
AC2: D1.3, D7.2 (A), D8.1 (K), J2.1
FET_GATE: Q2.1 (G), R19.2, R20.2
GND: C1.2, C2.2, C3.2, C4.2, C5.2, C9.2, C10.2, C12.1, C16.1, C17.2, C18.2, C20.2, J5.3, J5.5, J5.7, Q1.2 (S), R1.2, R13.2, R14.2, R16.1, R17.1, U1.4 (V-), U2.2 (-VIN), U3.3 (IN-), U3.4 (GND), U4.2 (GND)
ISENSE: J5.2, U4.3 (VIOUT)
unnamed: D1.1 (+), R2.2, R6.1
unnamed: D1.2 (-), R3.1, R7.1
unnamed: D2.2 (A), D3.2 (A)
unnamed: C2.1, C4.1, D2.1 (K), R8.2, T1.1 (PRI_1)
unnamed: D3.1 (K), Q1.3 (D), T1.3 (PRI_3)
unnamed: D4.2 (A), T1.6 (SEC_3)
unnamed: D4.1 (K), R15.1, R18.1
unnamed: D5.3 (G), R15.2
unnamed: D7.3 (G), R18.2
unnamed: R2.1, R3.2
unnamed: R4.2, R9.1
unnamed: R5.2, R10.1
unnamed: R6.2, R11.1
unnamed: R7.2, R12.1
unnamed: R23.1, R24.2
unnamed: R24.1, R25.2
unnamed: R25.1, R26.2
unnamed: C7.1, C10.1, R11.2, R14.1, U1.3 (+)
unnamed: C7.2, C14.2, R12.2, R17.2, R22.2, U1.2 (-)
unnamed: C6.1, C9.1, R9.2, R13.1, U1.5 (+)
unnamed: C6.2, C13.2, R10.2, R16.2, R21.2, U1.6 (-)
unnamed: C8.1, C11.1, C23.1, U2.7 (+VOUT), U3.5 (VH)
unnamed: C8.2, C11.2, C24.2, U2.5 (-VOUT), U3.8 (GNDISO)
unnamed: R20.1, U3.7 (GOFF)
unnamed: R19.1, U3.6 (GON)
PFC: J5.4, U3.2 (IN+)
SCR_TRIG: C5.1, J5.6, Q1.1 (G), R1.1
V+: C19.1, C21.1, C22.1, D9.2 (K), J6.1, R4.1, R26.1
V-: C15.2, C19.2, C21.2, C22.2, C23.2, C24.1, D6.2 (A), D8.2 (A), J7.1, Q2.3 (S), R5.1, R23.2, U2.6 (0V)
VAC_SENSE: C14.1, J5.10, R22.1, U1.1
VBUS_SENSE: C13.1, J5.8, R21.1, U1.7
