flyingperson23/Booster-TC/hardware/booster-pfc-v3/booster-tc.kicad_pcb

## KiCad design hardware/booster-pfc-v3/booster-tc.kicad_pcb (continued)

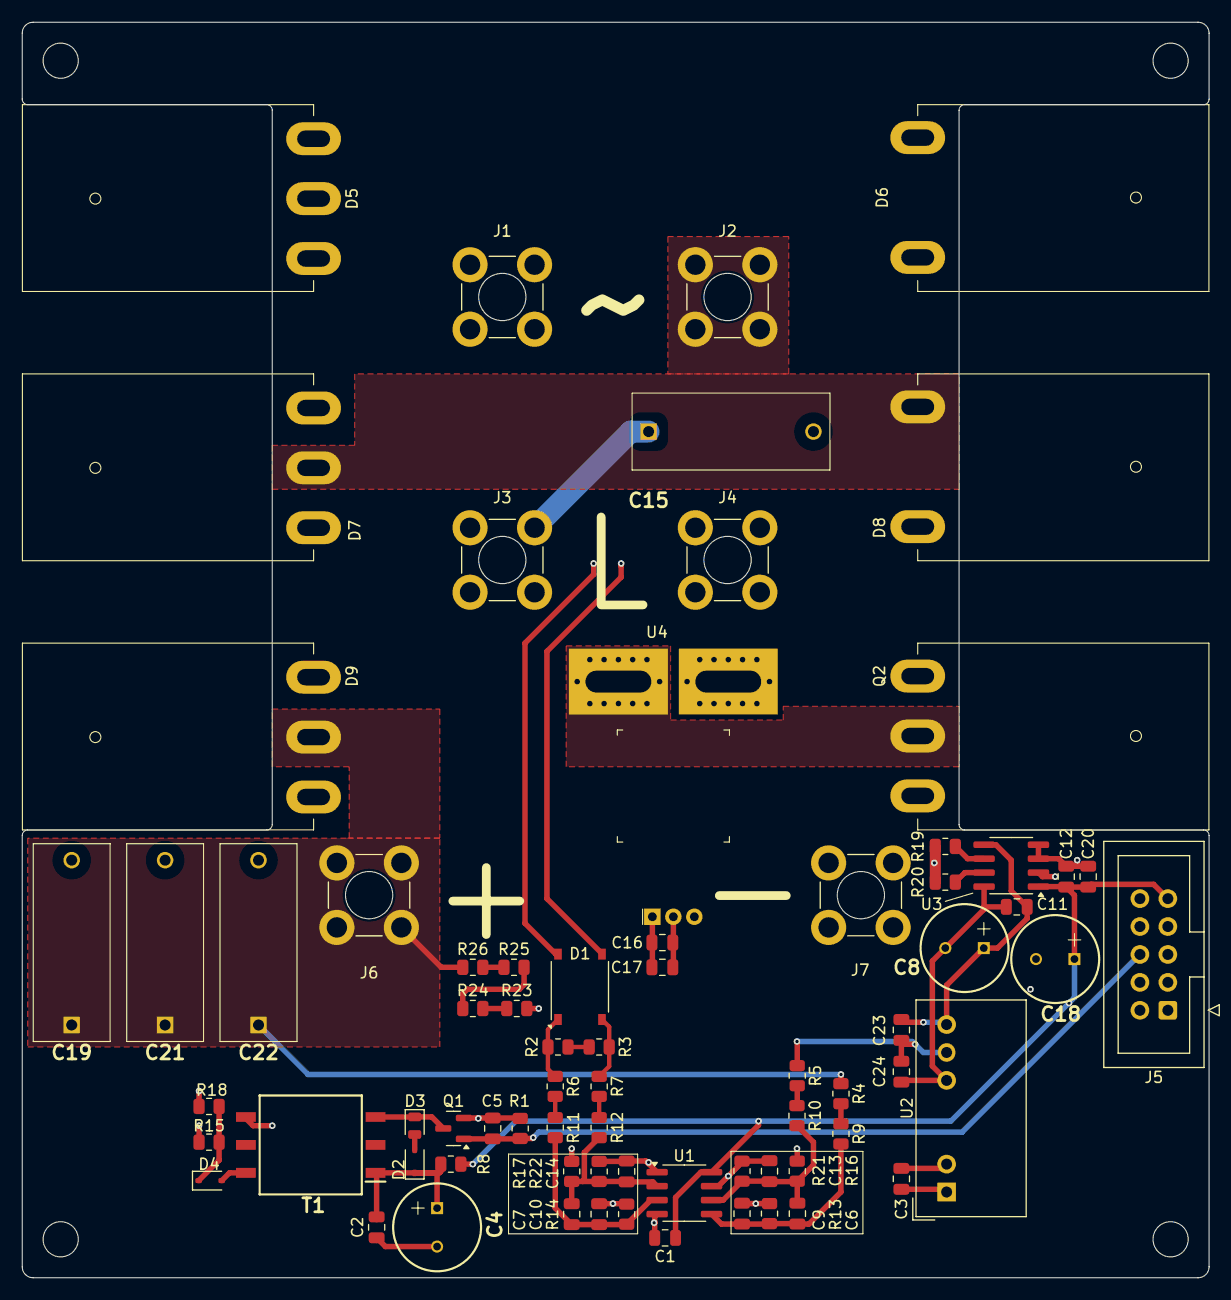
[picture p9: board hardware/booster-pfc-v3/booster-tc.kicad_pcb from above]

Board: 4 copper layers, 108.0 x 114.2 mm, 77 parts (0 on the bottom side), 41 nets.
