flyingperson23/Booster-TC/hardware/booster-pfc-v2/booster-tc.kicad_pcb

## KiCad design hardware/booster-pfc-v2/booster-tc.kicad_pcb (2024-07-02, an earlier design)

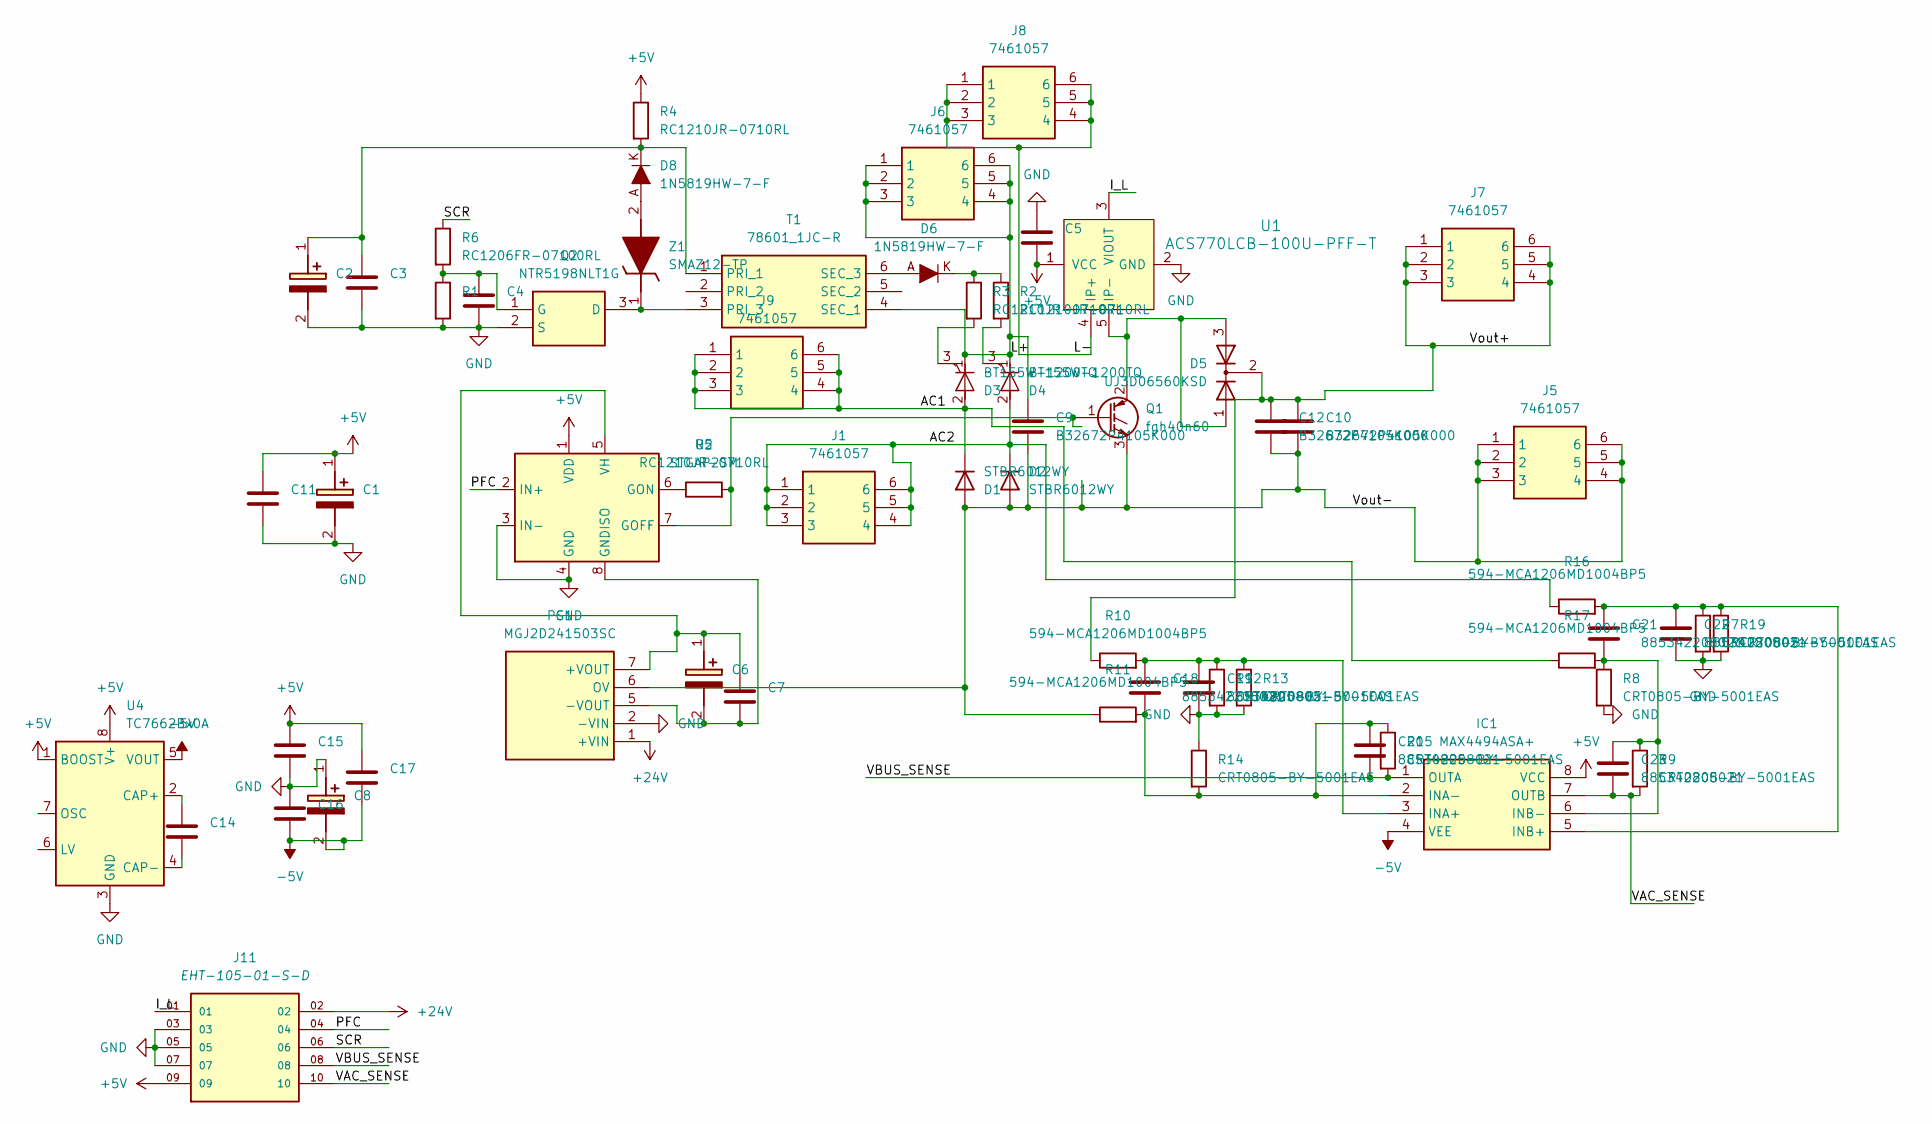
[picture p10: schematic booster-tc.kicad_sch]

Parts:
C1, C2, C6, C8: 860020474014; CAPPRD350W52D800H1300; Mouser Part Number 710-860020474014
C3, C5, C7: 885012210031; C_1812_4532Metric_Pad1.57x3.40mm_HandSolder
C4, C11, C14, C15, C16, C17: 885012208022; C_1206_3216Metric_Pad1.33x1.80mm_HandSolder
C9, C10, C12: B32672P4105K000
C18, C19, C20, C21, C22, C23: 885342208021; C_1206_3216Metric_Pad1.33x1.80mm_HandSolder
D1, D2: STBR6012WY; TO-247-2_Horizontal_TabDown
D3, D4: BT155W-1200TQ; TO-247-3_Horizontal_TabDown
D5: UJ3D06560KSD; TO-247-3_Horizontal_TabDown
D6, D8: 1N5819HW-7-F; SOD-123; MPN 1N5819HW-7-F
IC1: MAX4494ASA+; SOIC127P600X175-8N; Mouser Part Number 700-MAX4494ASA
J1, J5, J6, J7, J8, J9: 7461057; Mouser Part Number 710-7461057
J11: EHT-105-01-S-D; SAMTEC_EHT-105-01-S-D
PS1: MGJ2D241503SC; Mouser Part Number 580-MGJ2D241503SC
Q1: fgh40n60; TO-247-3_Horizontal_TabDown
Q2: NTR5198NLT1G; SOT96P237X111-3N; Mouser Part Number 863-NTR5198NLT1G
R1: RC1206FR-0710KL; R_1206_3216Metric
R2, R3, R4, R5: RC1210JR-0710RL; C_1210_3225Metric_Pad1.33x2.70mm_HandSolder
R6: RC1206FR-07100RL; R_1206_3216Metric_Pad1.30x1.75mm_HandSolder
R7, R8, R9, R12, R13, R14, R15, R19: CRT0805-BY-5001EAS; R_0805_2012Metric_Pad1.20x1.40mm_HandSolder
R10, R11, R16, R17: 594-MCA1206MD1004BP5; R_1206_3216Metric_Pad1.30x1.75mm_HandSolder
T1: 78601_1JC-R; SOP254P1270X665-6N; Mouser Part Number 580-78601/1JC-R
U1: ACS770LCB-100U-PFF-T; CB-5_Formed_Leads; MPN ACS770LCB-100U-PFF-T
U2: STGAP2SM; SOIC-8_3.9x4.9mm_P1.27mm
U4: TC7662Bx0A; SOIC-8_3.9x4.9mm_P1.27mm
Z1: SMAZ12-TP; DIOM5226X244N; Mouser Part Number 833-SMAZ12-TP

Connections:
+5V: C1.1 (+), C5.2, C11.1, C15.1, C17.1, IC1.8 (VCC), J11.09, R4.1, U1.1 (VCC), U2.1 (VDD), U4.1 (BOOST), U4.8 (V+)
+24V: J11.02, PS1.1 (+VIN)
-5V: C8.2 (-), C16.2, C17.2, IC1.4 (VEE), U4.5 (VOUT)
/AC1: D1.1 (K), D3.2 (A), J9.1, J9.2, J9.3, J9.4, J9.5, J9.6, R17.1
/AC2: D2.1 (K), D4.2 (A), J1.1, J1.2, J1.3, J1.4, J1.5, J1.6, R16.1
/I_L: J11.01, U1.3 (VIOUT)
/L+: C9.1, D3.1 (K), D4.1 (K), J6.1, J6.2, J6.3, J6.4, J6.5, J6.6, T1.4 (SEC_1)
/L-: J8.1, J8.2, J8.3, J8.4, J8.5, J8.6, U1.4 (IP+)
/PFC: J11.04, U2.2 (IN+)
/SCR: J11.06, R6.1
/VAC_SENSE: C23.2, IC1.7 (OUTB), J11.10, R9.2
/VBUS_SENSE: C20.2, IC1.1 (OUTA), J11.08, R15.2
/Vout+: C10.1, C12.1, D5.2 (K), J7.1, J7.2, J7.3, J7.4, J7.5, J7.6, R10.1
/Vout-: C9.2, C10.2, C12.2, D1.2 (A), D2.2 (A), J5.1, J5.2, J5.3, J5.4, J5.5, J5.6, PS1.6 (OV), Q1.3 (E), R11.1
GND: C1.2 (-), C2.2 (-), C3.2, C4.2, C5.1, C8.1 (+), C11.2, C15.2, C16.1, C19.2, C22.2, J11.03, J11.05, J11.07, PS1.2 (-VIN), Q2.2 (S), R1.2, R7.2, R8.2, R12.2, R13.2, R14.1, R19.2, U1.2 (GND), U2.3 (IN-), U2.4 (GND), U4.3 (GND)
unnamed: C2.1 (+), C3.1, D8.K, R4.2, T1.1 (PRI_1)
unnamed: C6.1 (+), C7.1, PS1.7 (+VOUT), U2.5 (VH)
unnamed: C6.2 (-), C7.2, PS1.5 (-VOUT), U2.8 (GNDISO)
unnamed: D3.3 (G), R3.2
unnamed: D4.3 (G), R2.2
unnamed: D6.K, R2.1, R3.1
unnamed: C18.1, C19.1, IC1.3 (INA+), R10.2, R12.1, R13.1
unnamed: C18.2, C20.1, IC1.2 (INA-), R11.2, R14.2, R15.1
unnamed: C21.1, C22.1, IC1.5 (INB+), R7.1, R16.2, R19.1
unnamed: C21.2, C23.1, IC1.6 (INB-), R8.1, R9.1, R17.2
unnamed: D5.1 (A), D5.3 (A), Q1.2 (C), U1.5 (IP-)
unnamed: Q1.1 (G), R5.2, U2.7 (GOFF)
unnamed: Q2.3 (D), T1.3 (PRI_3), Z1.1 (K)
unnamed: C4.1, Q2.1 (G), R1.1, R6.2
unnamed: D6.A, T1.6 (SEC_3)
unnamed: R5.1, U2.6 (GON)
unnamed: C14.1, U4.2 (CAP+)
unnamed: C14.2, U4.4 (CAP-)
unnamed: D8.A, Z1.2 (A)

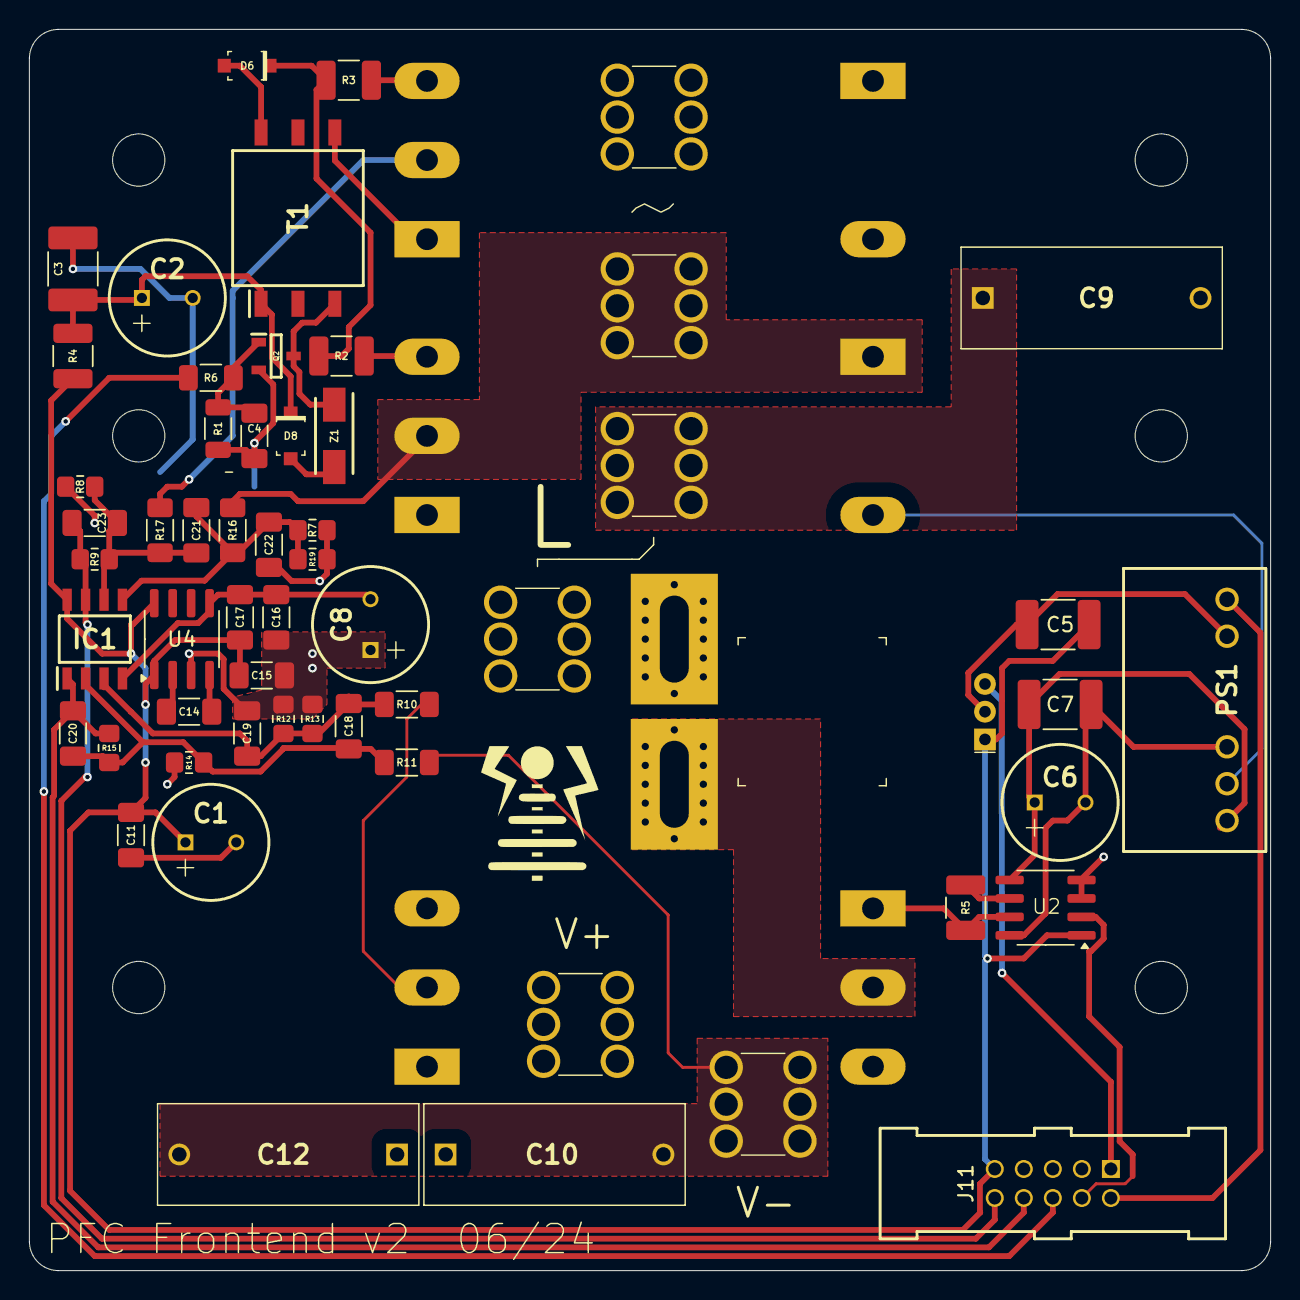
[picture p11: board hardware/booster-pfc-v2/booster-tc.kicad_pcb from above]

Board: 2 copper layers, 85.5 x 85.5 mm, 63 parts (0 on the bottom side), 34 nets.
