flyingperson23/Booster-TC/hardware/booster-ftdi-board/booster-ftdi-board.kicad_pcb

## KiCad design hardware/booster-ftdi-board/booster-ftdi-board.kicad_pcb (2024-09-24)

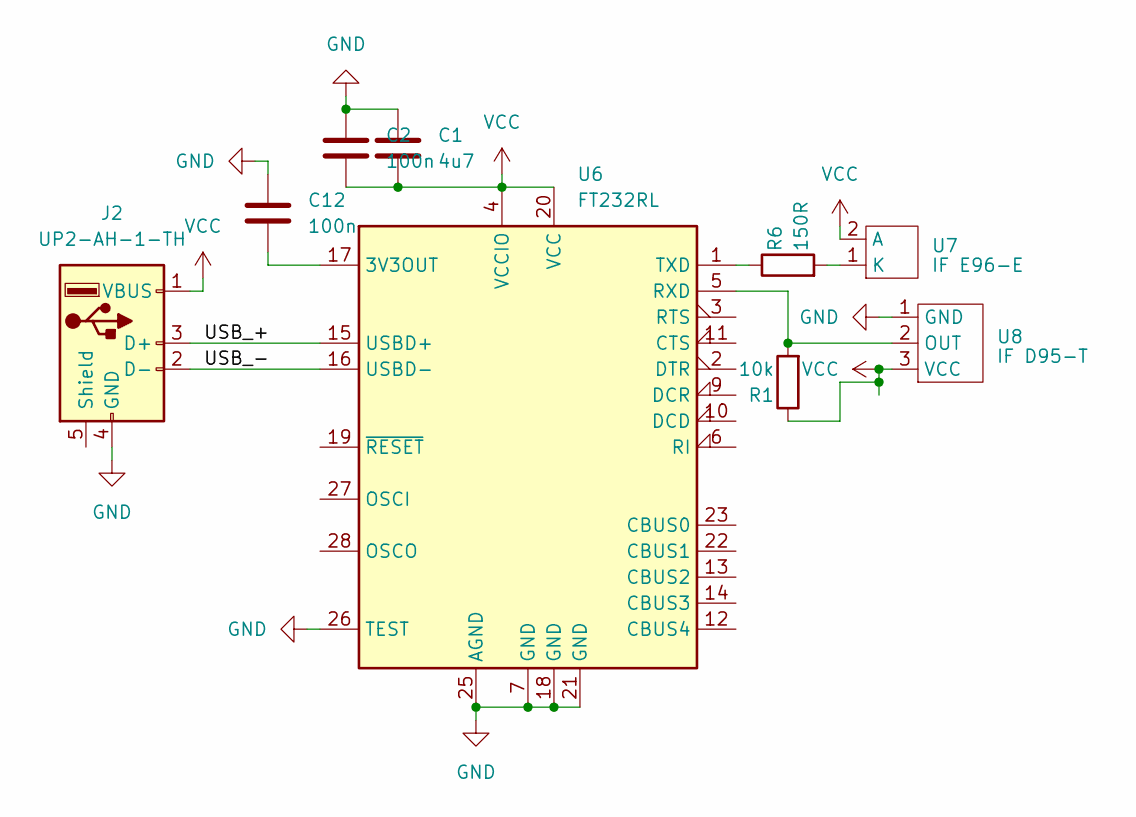
[picture p12: schematic booster-ftdi-board.kicad_sch]

Parts:
C1: 4u7; C_0805_2012Metric_Pad1.18x1.45mm_HandSolder
C2, C12: 100n; C_0805_2012Metric_Pad1.18x1.45mm_HandSolder
J2: UP2-AH-1-TH; USB_Male_A_UP2-AH-1-TH
R1: 10k; R_0805_2012Metric_Pad1.20x1.40mm_HandSolder
R6: 150R; R_0805_2012Metric_Pad1.20x1.40mm_HandSolder
U6: FT232RL; SSOP-28_5.3x10.2mm_P0.65mm
U7: IF E96-E; IF-E96E
U8: IF D95-T; IF-D95

Connections:
/USB_+: J2.3 (D+), U6.15 (USBD+)
/USB_-: J2.2 (D-), U6.16 (USBD-)
GND: C1.1, C2.1, C12.1, J2.4 (GND), U6.7 (GND), U6.18 (GND), U6.21 (GND), U6.25 (AGND), U6.26 (TEST), U8.1 (GND)
unnamed: C12.2, U6.17 (3V3OUT)
unnamed: R1.2, U6.5 (RXD), U8.2 (OUT)
unnamed: R6.1, U6.1 (TXD)
unnamed: R6.2, U7.1 (K)
VCC: C1.2, C2.2, J2.1 (VBUS), R1.1, U6.4 (VCCIO), U6.20 (VCC), U7.2 (A), U8.3 (VCC)

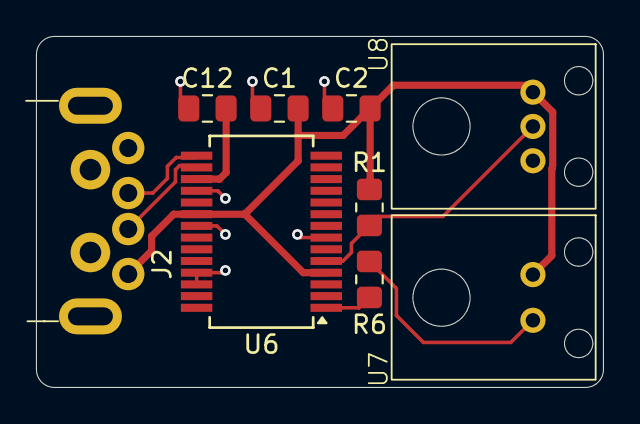
[picture p13: board booster-ftdi-board.kicad_pcb from above]

Board: 2 copper layers, 31.5 x 19.5 mm, 9 parts (0 on the bottom side), 8 nets.
