flyingperson23/Booster-TC/hardware/booster-tc-driver/booster-tc-driver.kicad_pcb

## KiCad design hardware/booster-tc-driver/booster-tc-driver.kicad_pcb (2024-09-24, an earlier design)

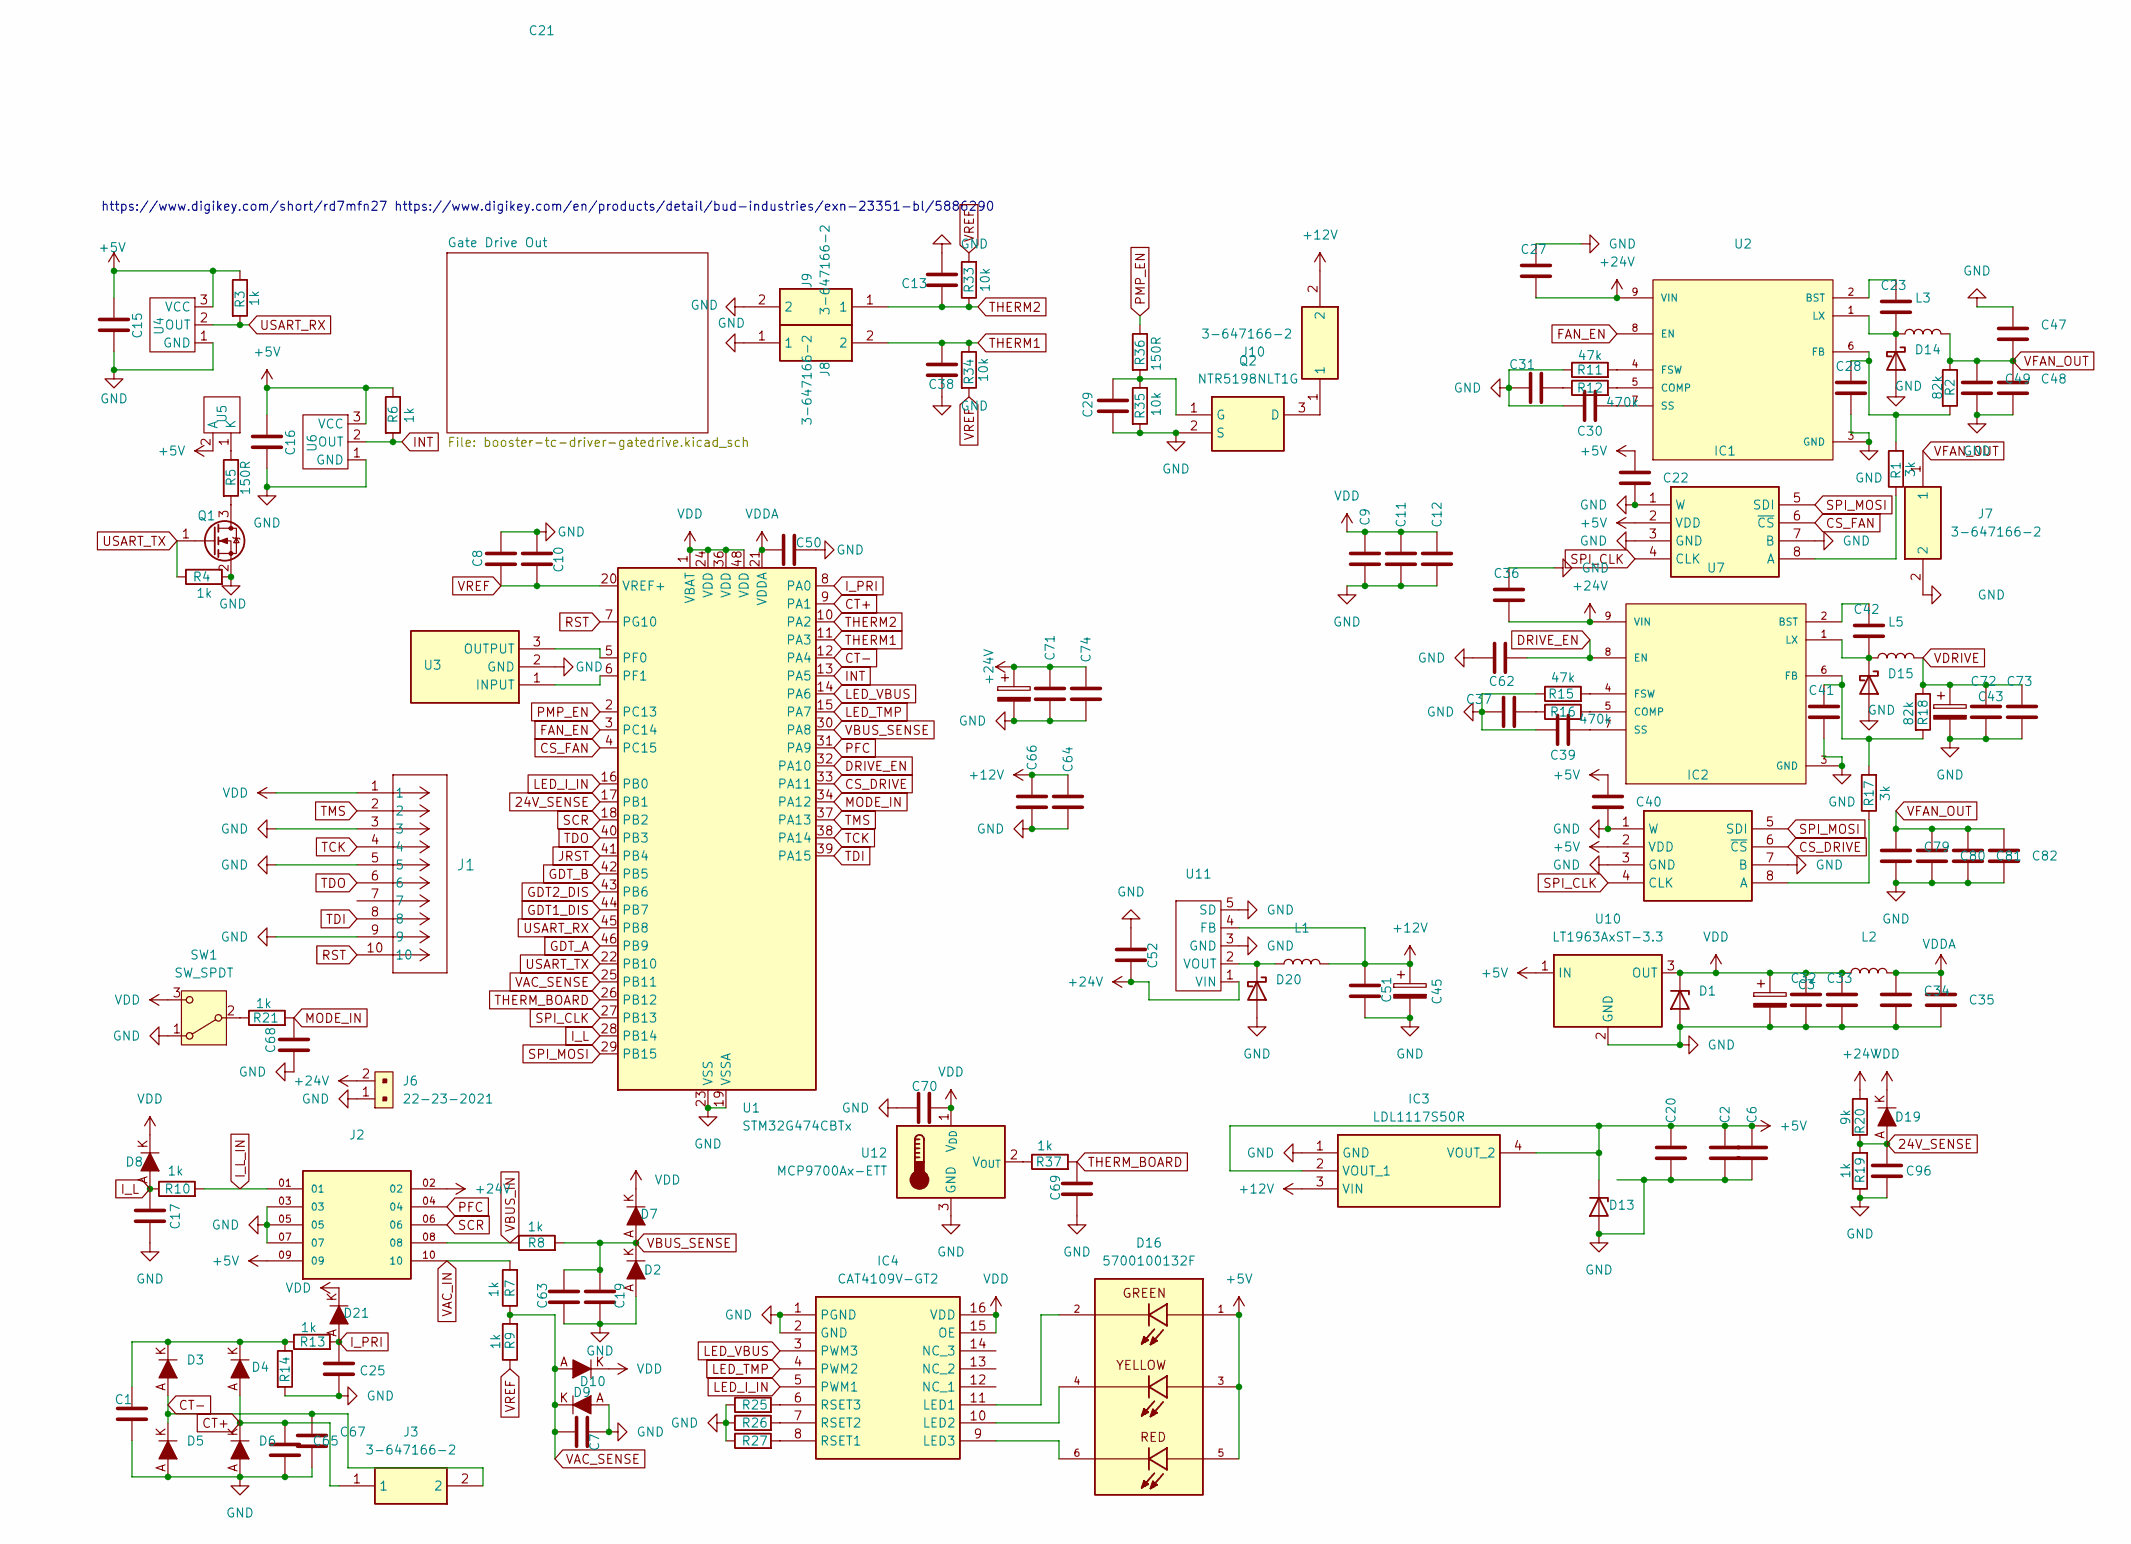
[picture p14: schematic booster-tc-driver.kicad_sch]

Parts:
C1, C17, C19, C25, C29, C31, C37: 1n CGA3EAC0G2A102J080AA; C_0603_1608Metric_Pad1.08x0.95mm_HandSolder
C2, C15, C16, C20, C34, C47, C48, C49, C79: 2u2 C3225X7R1H225K250AB; C_1210_3225Metric_Pad1.33x2.70mm_HandSolder
C3, C43, C45: 470u 860020474014; CAPPRD350W52D800H1300
C6, C22, C23, C27, C28, C32, C33, C36, C40, C41, C42, C51, C52, C64, C66, C70, C71, C72, C73, C74, C96: .1uf 885012208087; C_1206_3216Metric_Pad1.33x1.80mm_HandSolder
C7, C63, C69: 10n VJ0603Y103KXJAC31X; C_0603_1608Metric_Pad1.08x0.95mm_HandSolder
C8, C68: 1u C1206C105K5RACTU; C_1206_3216Metric_Pad1.33x1.80mm_HandSolder
C9, C10, C11, C12, C13, C35, C38, C50, C80, C81, C82: .1uf C0603C104K3RECTU; C_0603_1608Metric_Pad1.08x0.95mm_HandSolder
C21: 330u 860020575013; 860020575013
C30, C39, C62: 22n VJ0805Y223KBBBE31; C_0805_2012Metric_Pad1.18x1.45mm_HandSolder
C65, C67: 150p VJ0603A151JXAAC; C_0603_1608Metric_Pad1.08x0.95mm_HandSolder
D1: SMBJ3V3; DO-214AA
D2, D7, D8, D9, D10, D19, D21: MBR0530; SOD-123; MPN MBR0530
D3, D4, D5, D6: 1N5819HW-7-F; SOD-123; MPN 1N5819HW-7-F
D13: SMBJ5.0A-TR; DO-214AA
D14, D15, D20: PMEG4050EP; D_SOD-128
D16: 5700100132F; LED_5700100132F; PARTREV N
IC1, IC2: AD5160BRJZ5-RL7; SOT65P280X145-8N; Mouser Part Number 584-AD5160BRJZ5-R7
IC3: LDL1117S50R; SOT230P700X180-4N; Mouser Part Number 511-LDL1117S50R
IC4: CAT4109V-GT2; Mouser Part Number 698-CAT4109V-GT2
J1: 62201021121; CONN_62201021121_WRE
J2: EHT-105-01-S-D; SAMTEC_EHT-105-01-S-D
J3, J7, J8, J9, J10: 3-647166-2; 36471662; Mouser Part Number 571-3-647166-2
J6: 22-23-2021; PinHeader_1x2_P2.54mm_Drill1.02mm; MPN 22-23-2021
L1, L3, L5: 22u IHLP3232DZER220M5A; IND_IHLP-3232DZ_VIS-M
L2: 4u7 LQM2MPN4R7NG0L; LQM2MPN4R7NG0L
Q1: T2N7002AK; SOT-23
Q2: NTR5198NLT1G; SOT96P237X111-3N; Mouser Part Number 863-NTR5198NLT1G
R1, R17: 3k; R_0805_2012Metric_Pad1.20x1.40mm_HandSolder
R2, R18: 82k; R_0805_2012Metric_Pad1.20x1.40mm_HandSolder
R3, R4, R6, R7, R8, R9, R10, R13, R19, R21, R37: 1k; R_0805_2012Metric_Pad1.20x1.40mm_HandSolder
R5, R36: 150R; R_0805_2012Metric_Pad1.20x1.40mm_HandSolder
R11, R15: 47k; R_0805_2012Metric_Pad1.20x1.40mm_HandSolder
R12, R16: 470k; R_0805_2012Metric_Pad1.20x1.40mm_HandSolder
R14: 2R2 35222R2JT; R_2512_6332Metric_Pad1.40x3.35mm_HandSolder
R20: 9k; R_0805_2012Metric_Pad1.20x1.40mm_HandSolder
R25, R26, R27: 24k9 CRCW060324K9FKEA; R_0603_1608Metric_Pad0.98x0.95mm_HandSolder
R33, R34, R35: 10k; R_0805_2012Metric_Pad1.20x1.40mm_HandSolder
SW1: SW_SPDT; B12JV
U1: STM32G474CBTx; LQFP-48_7x7mm_P0.5mm
U2, U7: AOZ1284PI; SOIC-8-1EP_3.9x4.9mm_P1.27mm_EP2.29x3mm; PARTREV 0.5
U3: CSTNE8M00G550000R0; CSTNE16M0V530000R0; Mouser Part Number 81-CSTNE8M00G550000R
U4, U6: IF-D95T << must be T; IF-D95
U5: IF-E96E
U10: LT1963AxST-3.3; SOT-223-3_TabPin2
U11: AP1501A-12K5G-13; TO-263-5_TabPin3
U12: MCP9700Ax-ETT; SOT-23

Connections:
24V_SENSE: C96.1, D19.A, R19.2, R20.2, U1.17 (PB1)
+5V: C2.1, C6.1, C15.1, C16.1, C20.1, C22.2, C40.2, D13.1 (K), D16.1, D16.3, D16.5, IC1.2 (VDD), IC2.2 (VDD), IC3.2 (VOUT_1), IC3.4 (VOUT_2), J2.09, R3.1, R6.1, U4.3 (VCC), U5.2 (A), U6.3 (VCC), U10.1 (IN)
+12V: C45.1, C51.1, C64.1, C66.1, IC3.3 (VIN), J10.2, L1.2, U11.4 (FB); also elsewhere on the board
+24V: C21.1, C27.2, C36.2, C52.2, C71.1, C74.1, J2.02, J6.2, R20.1, U2.9 (VIN), U7.9 (VIN), U11.1 (VIN)
CS_DRIVE: IC2.6 (~CS), U1.33 (PA11)
CS_FAN: IC1.6 (~CS), U1.4 (PC15)
CT+: C65.1, D4.A, D6.K, J3.1, U1.9 (PA1)
CT-: C67.1, D3.A, D5.K, J3.2, U1.12 (PA4)
DRIVE_EN: C62.1, U1.32 (PA10), U7.8 (EN)
FAN_EN: U1.3 (PC14), U2.8 (EN)
GDT1_DIS: U1.44 (PB7); also elsewhere on the board
GDT2_DIS: U1.43 (PB6); also elsewhere on the board
GDT_A: U1.46 (PB9); also elsewhere on the board
GDT_B: U1.42 (PB5); also elsewhere on the board
GND: C1.2, C2.2, C3.2, C6.2, C7.2, C8.1, C9.2, C10.1, C11.2, C12.2, C13.2, C15.2, C16.2, C17.2, C19.2, C20.2, C21.2, C22.1, C25.2, C27.1, C28.2, C29.2, C30.2, C31.1, C32.2, C33.2, C34.2, C35.1, C36.1, C37.1, C38.1, C39.2, C40.1, C41.2, C43.2, C45.2, C47.1, C48.2, C49.2, C50.2, C51.2, C52.1, C62.2, C63.2, C64.2, C65.2, C66.2, C67.2, C68.2, C69.2, C70.1, C71.2, C72.2, C73.2, C74.2, C79.2, C80.1, C81.1, C82.1, C96.2, D1.2 (A), D2.A, D5.A, D6.A, D9.A, D13.2 (A), D14.2 (A), D15.2 (A), D20.2 (A), IC1.1 (W), IC1.3 (GND), IC1.7 (B), IC2.1 (W), IC2.3 (GND), IC2.7 (B), IC3.1 (GND), IC4.1 (PGND), IC4.2 (GND), J1.3, J1.5, J1.9, J2.03, J2.05, J2.07, J6.1, J7.2, J8.2, J9.1, Q1.2 (S), Q2.2 (S), R4.2, R11.1, R14.2, R15.1, R19.1, R25.1, R26.1, R27.1, R35.2, SW1.1 (A), U1.19 (VSSA), U1.23 (VSS), U1.35 (VSS), U1.47 (VSS), U2.3 (GND), U3.2 (GND), U4.1 (GND), U6.1 (GND), U7.3 (GND), U10.2 (GND), U11.3 (GND), U11.5 (SD), U12.3 (GND); also elsewhere on the board
INT: R6.2, U1.13 (PA5), U6.2 (OUT)
I_L: C17.1, D8.A, R10.1, U1.28 (PB14)
I_L_IN: J2.01, R10.2
I_PRI: C25.1, D21.A, R13.2, U1.8 (PA0)
JRST: U1.41 (PB4)
LED_I_IN: IC4.5 (PWM1), U1.16 (PB0)
LED_TMP: IC4.4 (PWM2), U1.15 (PA7)
LED_VBUS: IC4.3 (PWM3), U1.14 (PA6)
MODE_IN: C68.1, R21.2, U1.34 (PA12)
unnamed: C1.1, D3.K, D4.K, R13.1, R14.1
unnamed: C31.2, R12.1
unnamed: C37.2, R16.1
unnamed: C23.2, D14.1 (K), L3.1, U2.1 (LX)
unnamed: C42.2, D15.1 (K), L5.1, U7.1 (LX)
unnamed: D20.1 (K), L1.1, U11.2 (VOUT)
unnamed: IC1.8 (A), R1.1
unnamed: IC2.8 (A), R17.1
unnamed: D16.2, IC4.11 (LED1)
unnamed: D16.4, IC4.10 (LED2)
unnamed: D16.6, IC4.9 (LED3)
unnamed: IC4.8 (RSET1), R27.2
unnamed: IC4.7 (RSET2), R26.2
unnamed: IC4.6 (RSET3), R25.2
unnamed: Q1.3 (D), R5.2
unnamed: J10.1, Q2.3 (D)
unnamed: C29.1, Q2.1 (G), R35.1, R36.2
unnamed: R21.1, SW1.2 (B)
unnamed: U1.5 (PF0), U3.3 (OUTPUT)
unnamed: U1.6 (PF1), U3.1 (INPUT)
unnamed: C23.1, U2.2 (BST)
unnamed: R12.2, U2.5 (COMP)
unnamed: C28.1, R1.2, R2.2, U2.6 (FB)
unnamed: R11.2, U2.4 (FSW)
unnamed: C30.1, U2.7 (SS)
unnamed: R5.1, U5.1 (K)
unnamed: C42.1, U7.2 (BST)
unnamed: R16.2, U7.5 (COMP)
unnamed: C41.1, R17.2, R18.2, U7.6 (FB)
unnamed: R15.2, U7.4 (FSW)
unnamed: C39.1, U7.7 (SS)
unnamed: R37.1, U12.2 (V_{OUT})
PFC: J2.04, U1.31 (PA9)
PMP_EN: R36.1, U1.2 (PC13)
RST: J1.10, U1.7 (PG10)
SCR: J2.06, U1.18 (PB2)
SPI_CLK: IC1.4 (CLK), IC2.4 (CLK), U1.27 (PB13)
SPI_MOSI: IC1.5 (SDI), IC2.5 (SDI), U1.29 (PB15)
TCK: J1.4, U1.38 (PA14)
TDI: J1.8, U1.39 (PA15)
TDO: J1.6, U1.40 (PB3)
THERM1: C38.2, J9.2, R34.1, U1.11 (PA3)
THERM2: C13.1, J8.1, R33.1, U1.10 (PA2)
THERM_BOARD: C69.1, R37.2, U1.26 (PB12)
TMS: J1.2, U1.37 (PA13)
USART_RX: R3.2, U1.45 (PB8), U4.2 (OUT)
USART_TX: Q1.1 (G), R4.1, U1.22 (PB10)
VAC_IN: J2.10, R7.2
VAC_SENSE: C7.1, D9.K, D10.A, R7.1, R9.2, U1.25 (PB11)
VBUS_IN: J2.08, R8.1
VBUS_SENSE: C19.1, C63.1, D2.K, D7.A, R8.2, U1.30 (PA8)
VDD: C3.1, C9.1, C11.1, C12.1, C32.1, C33.1, C70.2, D1.1 (K), D7.K, D8.K, D10.K, D19.K, D21.K, IC4.15 (OE), IC4.16 (VDD), J1.1, L2.1, SW1.3 (C), U1.1 (VBAT), U1.24 (VDD), U1.36 (VDD), U1.48 (VDD), U10.3 (OUT), U12.1 (V_{DD})
VDDA: C34.1, C35.2, C50.1, L2.2, U1.21 (VDDA)
VDRIVE: C43.1, C72.1, C73.1, L5.2, R18.1; also elsewhere on the board
VFAN_OUT: C47.2, C48.1, C49.1, C79.1, C80.2, C81.2, C82.2, J7.1, L3.2, R2.1
VREF: C8.2, C10.2, R9.1, R33.2, R34.2, U1.20 (VREF+)

Notes on the sheet:
https://www.digikey.com/short/rd7mfn27 https://www.digikey.com/en/products/detail/bud-industries/exn-23351-bl/5886290

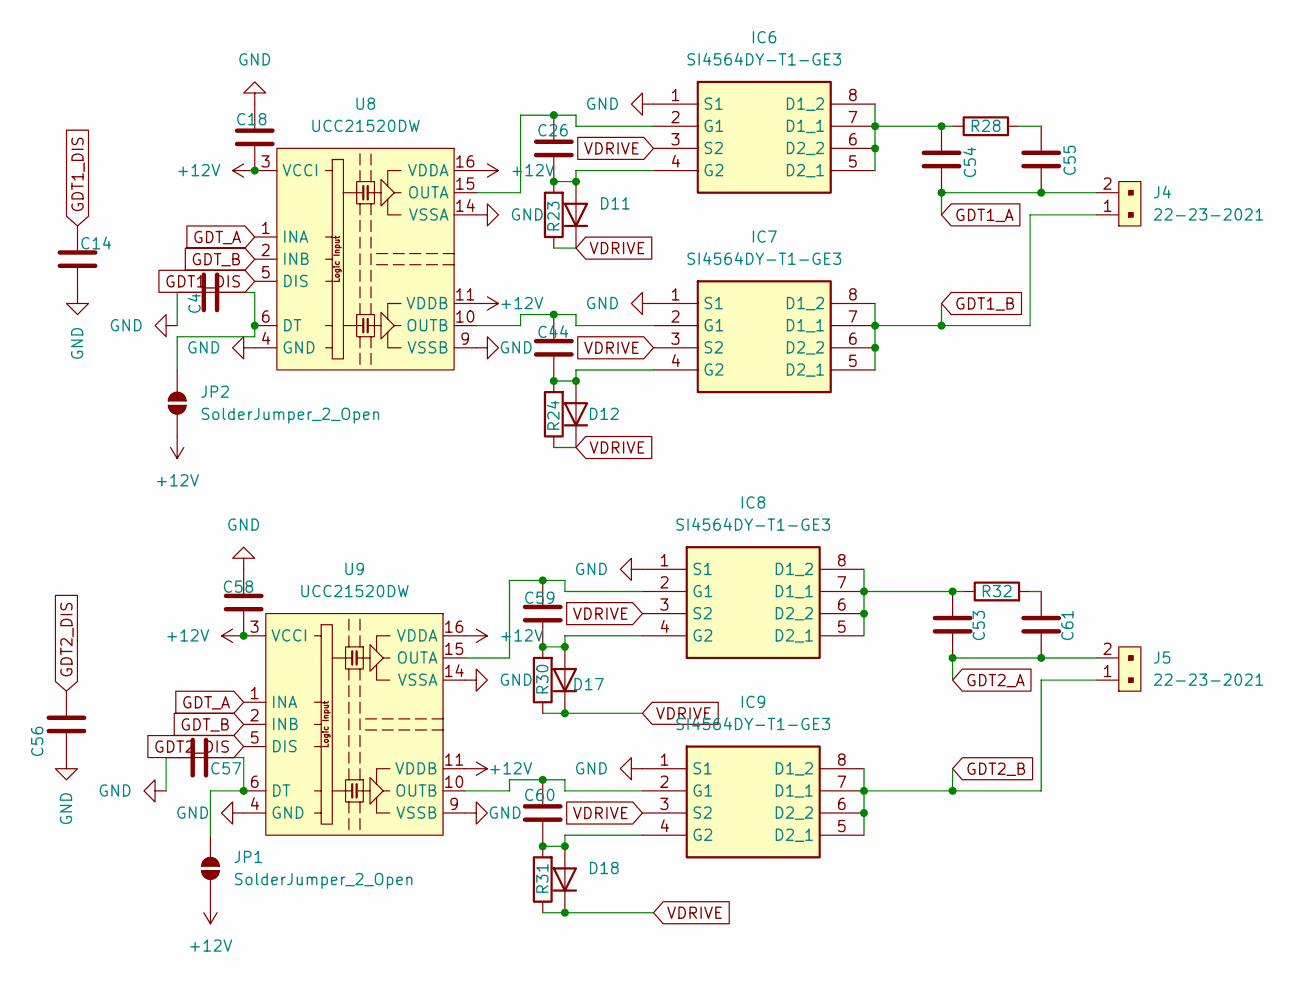
[picture p15: schematic booster-tc-driver-gatedrive.kicad_sch]

Parts:
C4, C57: 22n VJ0805Y223KBBBE31; C_0805_2012Metric_Pad1.18x1.45mm_HandSolder
C14, C56: 1n CGA3EAC0G2A102J080AA; C_0603_1608Metric_Pad1.08x0.95mm_HandSolder
C18, C26, C44, C58, C59, C60: .1uf 885012208087; C_1206_3216Metric_Pad1.33x1.80mm_HandSolder
C53, C54: 2u2 C3225X7R1H225K250AB; C_1210_3225Metric_Pad1.33x2.70mm_HandSolder
C55, C61: 1u C1206C105K5RACTU; C_1206_3216Metric_Pad1.33x1.80mm_HandSolder
D11, D12, D17, D18: MCL4148; D_MicroMELF
IC6, IC7, IC8, IC9: SI4564DY-T1-GE3; SOIC127P600X175-8N; Mouser Part Number 781-SI4564DY-T1-GE3
J4, J5: 22-23-2021; PinHeader_1x2_P2.54mm_Drill1.02mm; MPN 22-23-2021
JP1, JP2: SolderJumper_2_Open; SolderJumper-2_P1.3mm_Open_RoundedPad1.0x1.5mm
R23, R24, R30, R31: 1k MCU0805MD1051BP500; R_0805_2012Metric_Pad1.20x1.40mm_HandSolder
R28, R32: 15R CRCW121015R0JNEAHP; R_1210_3225Metric_Pad1.30x2.65mm_HandSolder
U8, U9: UCC21520DW; SOIC-16W_7.5x10.3mm_P1.27mm

Connections:
+12V: C18.2, C58.2, JP1.1 (A), JP2.1 (A), U8.3 (VCCI), U8.8 (VCCI), U8.11 (VDDB), U8.16 (VDDA), U9.3 (VCCI), U9.8 (VCCI), U9.11 (VDDB), U9.16 (VDDA); also elsewhere on the board
GDT1_A: C54.2, C55.2, J4.2
GDT1_B: IC7.5 (D2_1), IC7.6 (D2_2), IC7.7 (D1_1), IC7.8 (D1_2), J4.1
GDT1_DIS: C14.2, U8.5 (DIS); also elsewhere on the board
GDT2_A: C53.2, C61.2, J5.2
GDT2_B: IC9.5 (D2_1), IC9.6 (D2_2), IC9.7 (D1_1), IC9.8 (D1_2), J5.1
GDT2_DIS: C56.2, U9.5 (DIS); also elsewhere on the board
GDT_A: U8.1 (INA), U9.1 (INA); also elsewhere on the board
GDT_B: U8.2 (INB), U9.2 (INB); also elsewhere on the board
GND: C4.2, C14.1, C18.1, C56.1, C57.2, C58.1, IC6.1 (S1), IC7.1 (S1), IC8.1 (S1), IC9.1 (S1), U8.4 (GND), U8.9 (VSSB), U8.14 (VSSA), U9.4 (GND), U9.9 (VSSB), U9.14 (VSSA); also elsewhere on the board
unnamed: C55.1, R28.2
unnamed: C61.1, R32.2
unnamed: C26.2, D11.2 (A), IC6.4 (G2), R23.2
unnamed: C44.2, D12.2 (A), IC7.4 (G2), R24.2
unnamed: C59.2, D17.2 (A), IC8.4 (G2), R30.2
unnamed: C60.2, D18.2 (A), IC9.4 (G2), R31.2
unnamed: C54.1, IC6.5 (D2_1), IC6.6 (D2_2), IC6.7 (D1_1), IC6.8 (D1_2), R28.1
unnamed: C26.1, IC6.2 (G1), U8.15 (OUTA)
unnamed: C44.1, IC7.2 (G1), U8.10 (OUTB)
unnamed: C53.1, IC8.5 (D2_1), IC8.6 (D2_2), IC8.7 (D1_1), IC8.8 (D1_2), R32.1
unnamed: C59.1, IC8.2 (G1), U9.15 (OUTA)
unnamed: C60.1, IC9.2 (G1), U9.10 (OUTB)
unnamed: C57.1, JP1.2 (B), U9.6 (DT)
unnamed: C4.1, JP2.2 (B), U8.6 (DT)
VDRIVE: D11.1 (K), D12.1 (K), D17.1 (K), D18.1 (K), IC6.3 (S2), IC7.3 (S2), IC8.3 (S2), IC9.3 (S2), R23.1, R24.1, R30.1, R31.1; also elsewhere on the board

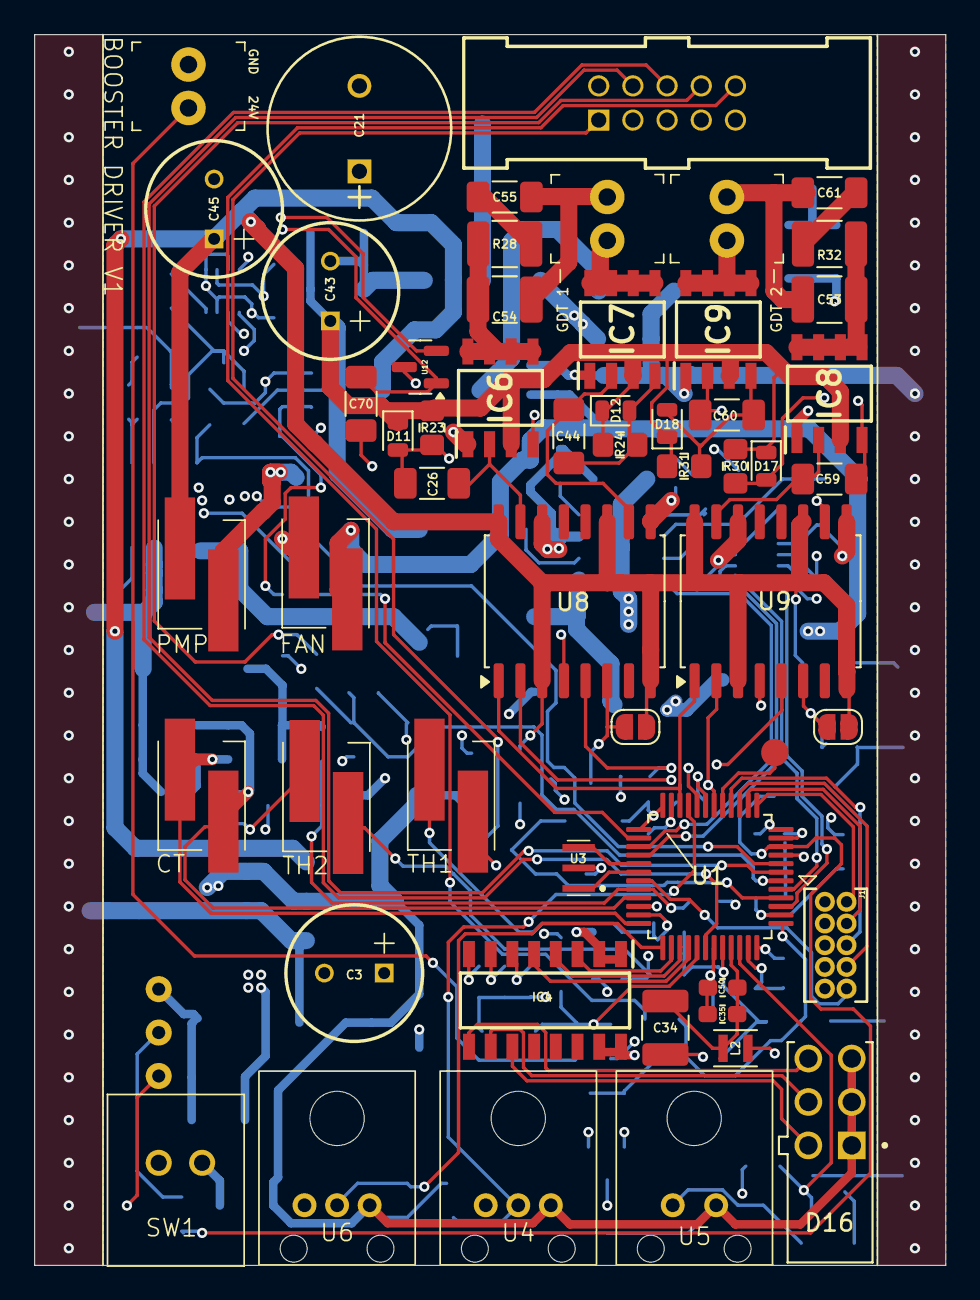
[picture p16: board hardware/booster-tc-driver/booster-tc-driver.kicad_pcb from above]

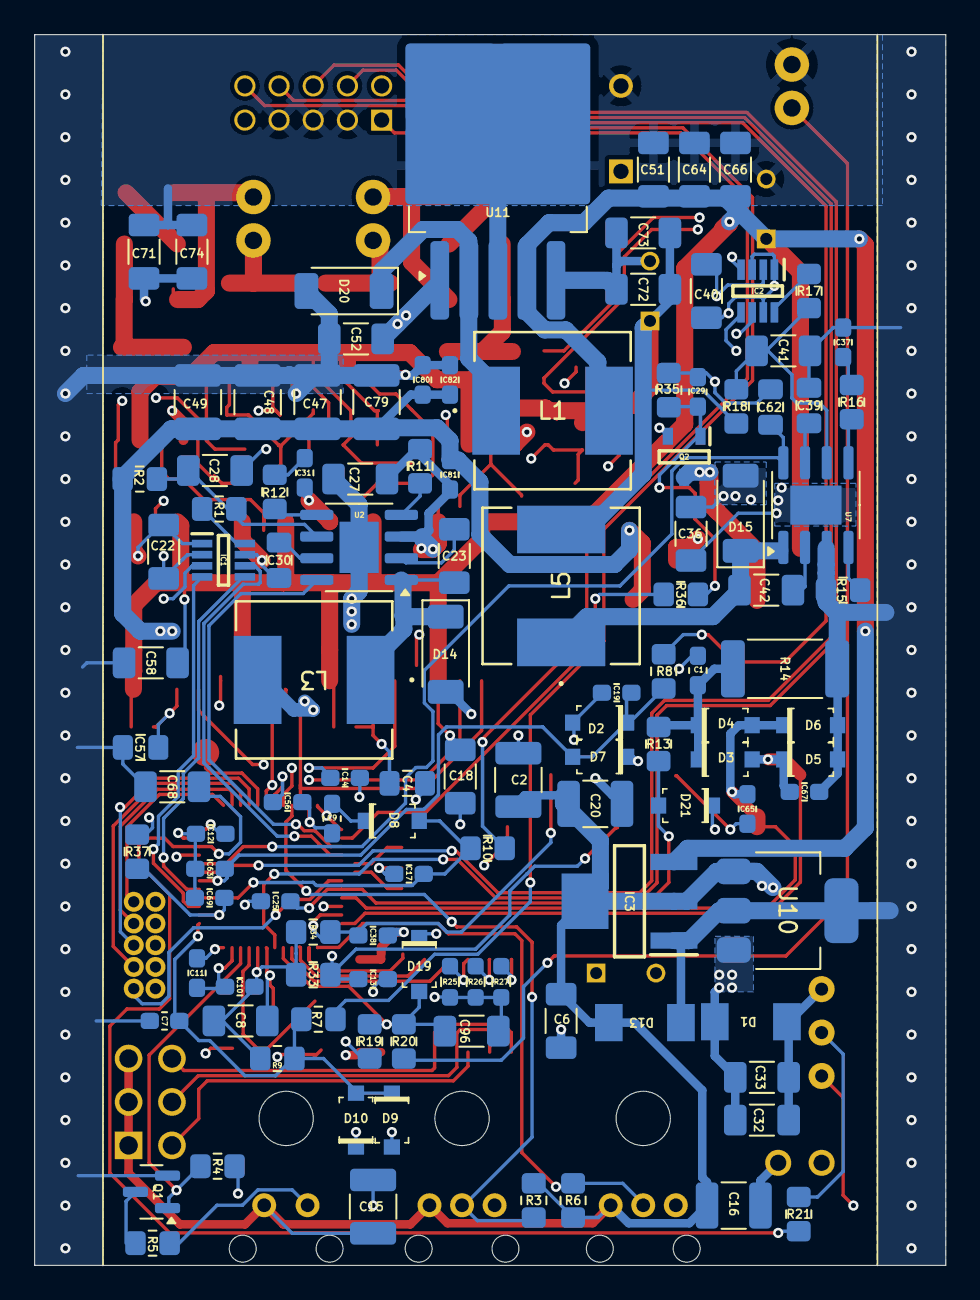
[picture p17: board hardware/booster-tc-driver/booster-tc-driver.kicad_pcb from below]

Board: 4 copper layers, 53.3 x 72.0 mm, 171 parts (117 on the bottom side), 97 nets.
