flyingperson23/Booster-TC/hardware/booster-I-board/booster-I-board.kicad_pcb

## KiCad design hardware/booster-I-board/booster-I-board.kicad_pcb (2024-07-31)

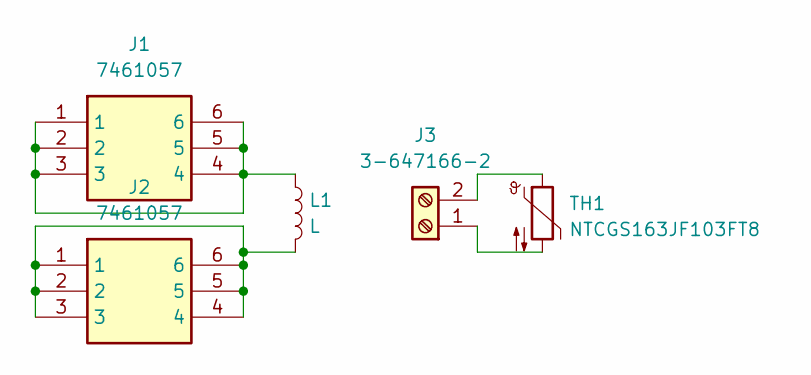
[picture p18: schematic booster-I-board.kicad_sch]

Parts:
J1, J2: 7461057; Mouser Part Number 710-7461057
J3: 3-647166-2; 36471662
L1: L; WE-TORPFC_T37_D53H28
TH1: NTCGS163JF103FT8; R_0603_1608Metric_Pad0.98x0.95mm_HandSolder

Connections:
unnamed: J1.1, J1.2, J1.3, J1.4, J1.5, J1.6, L1.1
unnamed: J2.1, J2.2, J2.3, J2.4, J2.5, J2.6, L1.2
unnamed: J3.1, TH1.2
unnamed: J3.2, TH1.1
