flyingperson23/Booster-TC/hardware/booster-I-board/booster-I-board.kicad_pcb

## KiCad design hardware/booster-I-board/booster-I-board.kicad_pcb (continued)

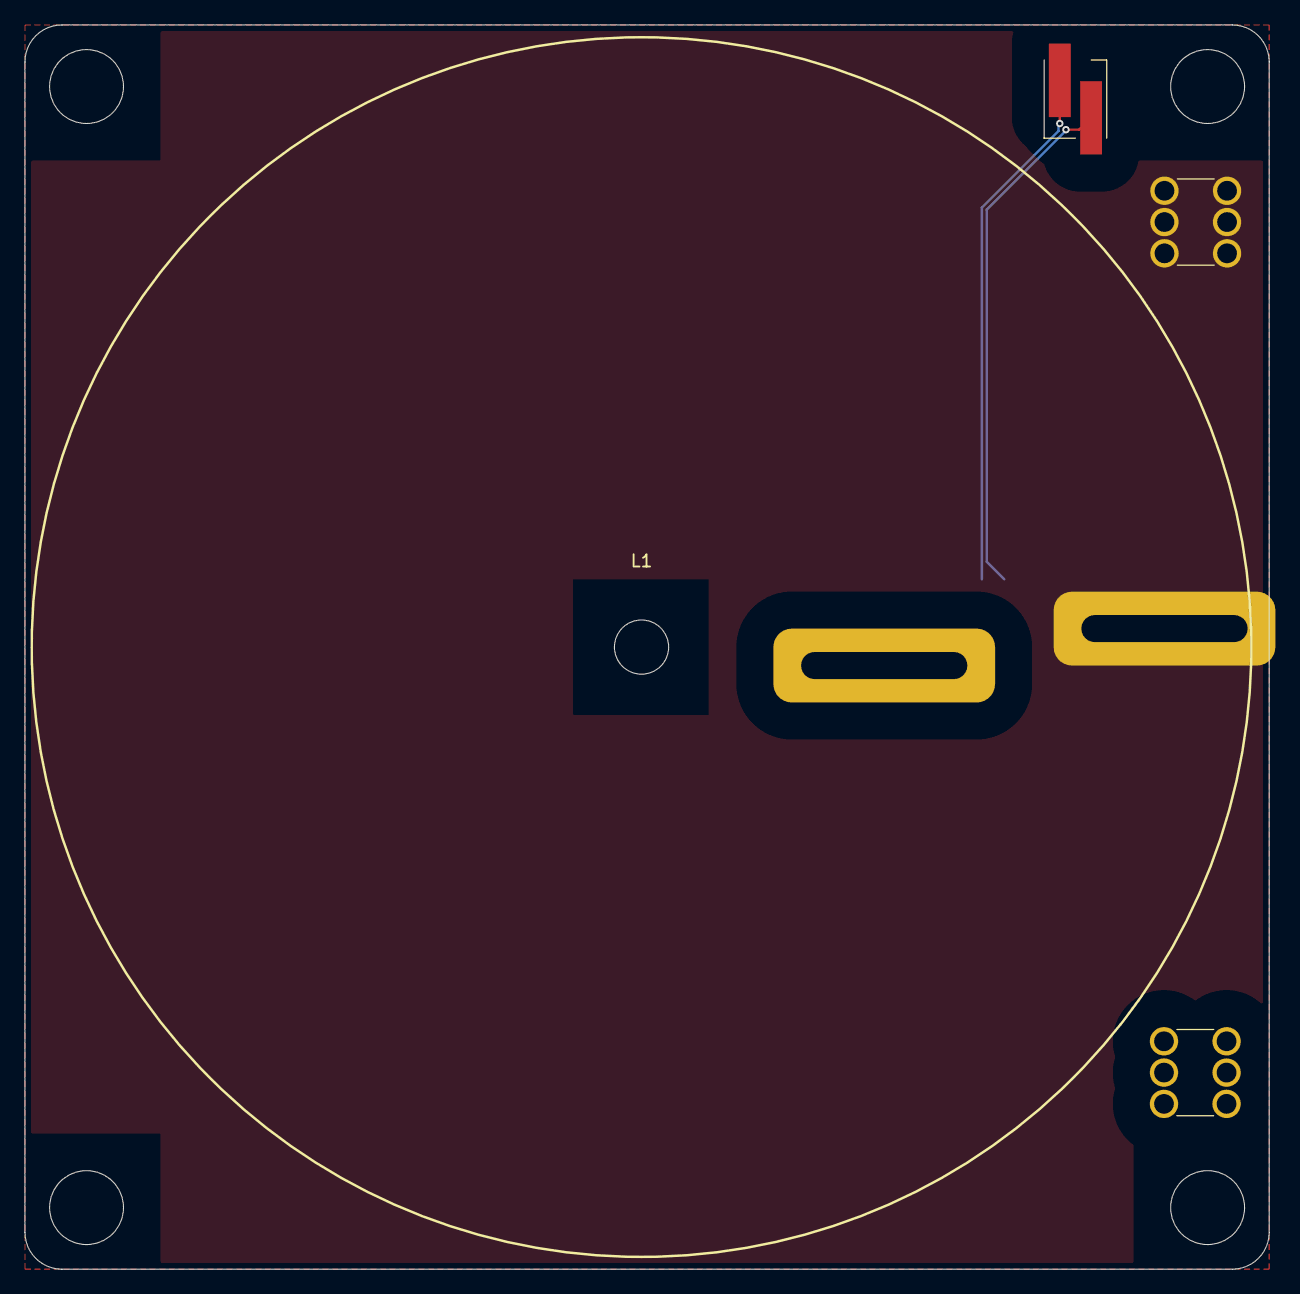
[picture p19: board booster-I-board.kicad_pcb from above]

Board: 2 copper layers, 101.0 x 101.0 mm, 5 parts (1 on the bottom side), 4 nets.
