flyingperson23/Booster-TC/hardware/gate-drive-board/gate-drive-board.kicad_pcb

## KiCad design hardware/gate-drive-board/gate-drive-board.kicad_pcb (2024-07-02)

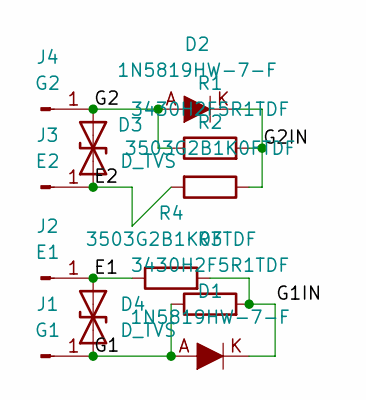
[picture p20: schematic gate-drive-board.kicad_sch]

Parts:
D1, D2: 1N5819HW-7-F; SOD-123; MPN 1N5819HW-7-F
D3, D4: D_TVS; D_SMC_Handsoldering
J1: G1; 3544-Spade
J2: E1; 3544-Spade
J3: E2; 3544-Spade
J4: G2; 3544-Spade
R1, R3: 3430H2F5R1TDF; R_1020_2550Metric_Pad1.33x5.20mm_HandSolder
R2, R4: 3503G2B1K0FTDF; R_1206_3216Metric_Pad1.30x1.75mm_HandSolder

Connections:
/E1: D4.2 (A2), J2.1, R4.1
/E2: D3.1 (A1), J3.1, R2.2
/G1: D1.A, D4.1 (A1), J1.1, R3.1
/G1IN: D1.K, R3.2, R4.2
/G2: D2.A, D3.2 (A2), J4.1, R1.1
/G2IN: D2.K, R1.2, R2.1

Board: 2 copper layers, 12 parts (0 on the bottom side), 6 nets, no tracks yet.
