flyingperson23/Booster-TC/hardware/booster-bus/booster-bus.kicad_pcb

## KiCad design hardware/booster-bus/booster-bus.kicad_pcb (2024-07-02)

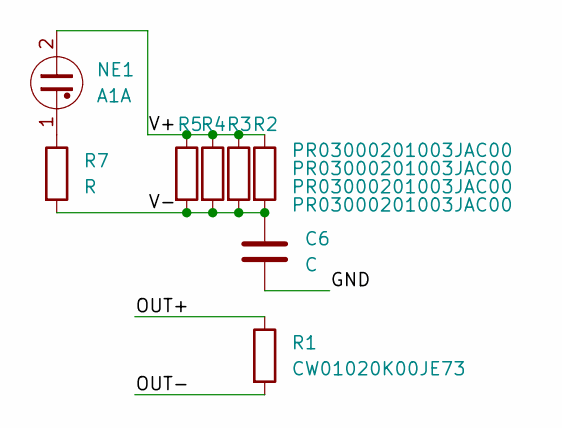
[picture p21: schematic booster-bus.kicad_sch]

Parts:
C6: C; ACX-MKP-0u47-630VDC
NE1: A1A; NEON-A1A
R1: CW01020K00JE73
R2, R3, R4, R5: PR03000201003JAC00
R7: R; R_Axial_DIN0207_L6.3mm_D2.5mm_P7.62mm_Horizontal

Connections:
/GND: C6.2
/OUT+: R1.1
/OUT-: R1.2
/V+: NE1.2, R2.1, R3.1, R4.1, R5.1
/V-: C6.1, R2.2, R3.2, R4.2, R5.2, R7.2
unnamed: NE1.1, R7.1

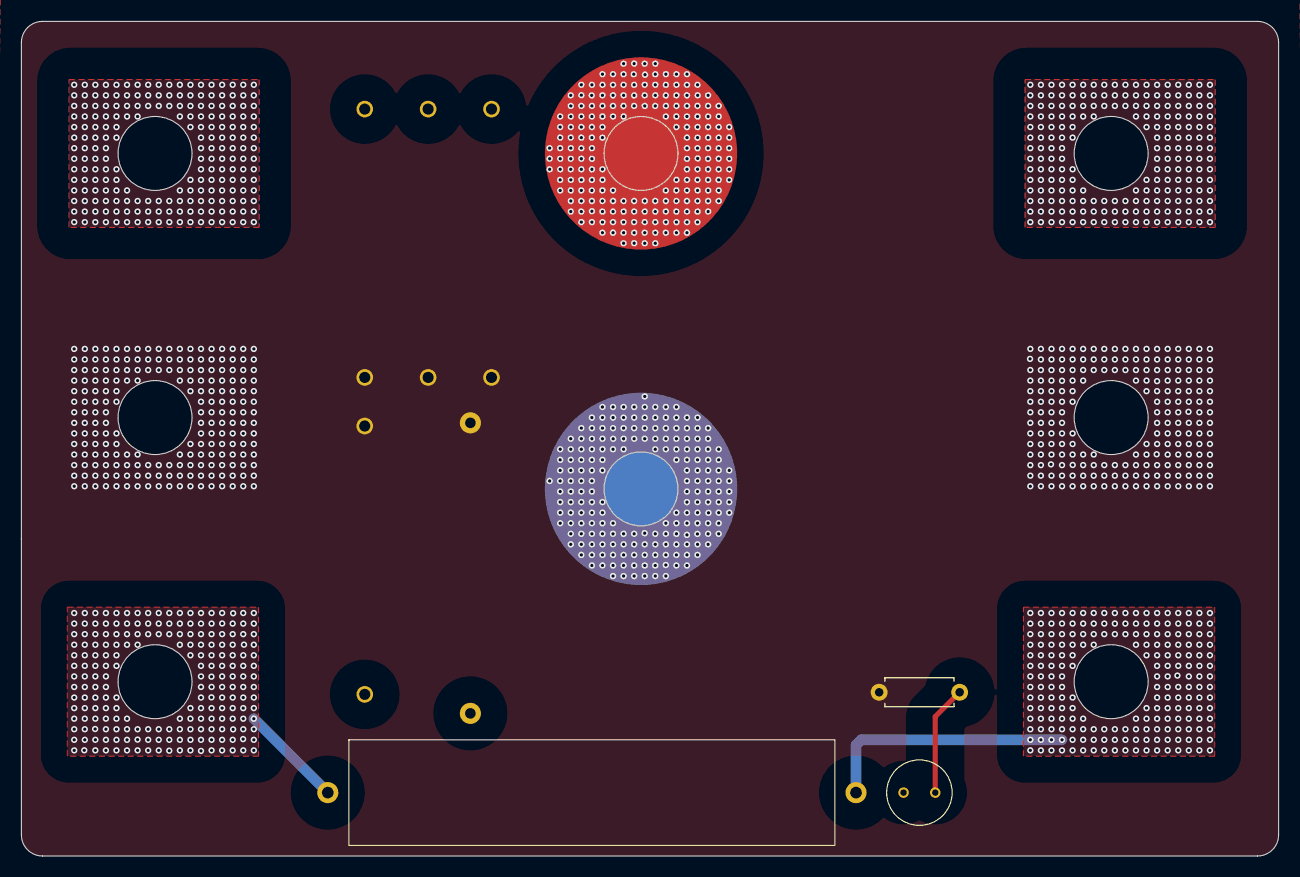
[picture p22: board booster-bus.kicad_pcb from above]

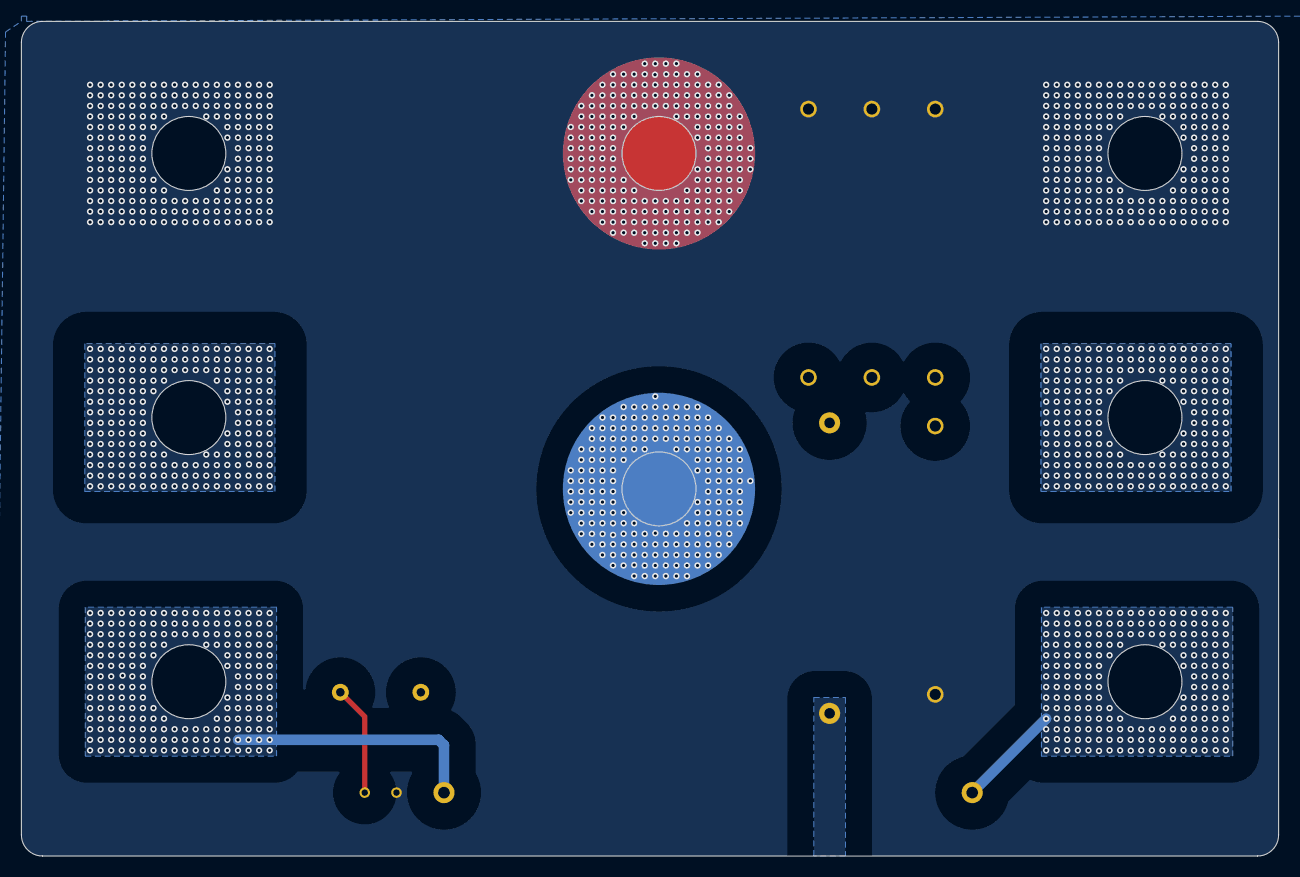
[picture p23: board booster-bus.kicad_pcb from below]

Board: 2 copper layers, 119.0 x 79.0 mm, 8 parts (5 on the bottom side), 3 nets.
