flyingperson23/Booster-TC/hardware/booster-emi-filter/booster-emi-filter.kicad_pcb

## KiCad design hardware/booster-emi-filter/booster-emi-filter.kicad_pcb (2024-07-02)

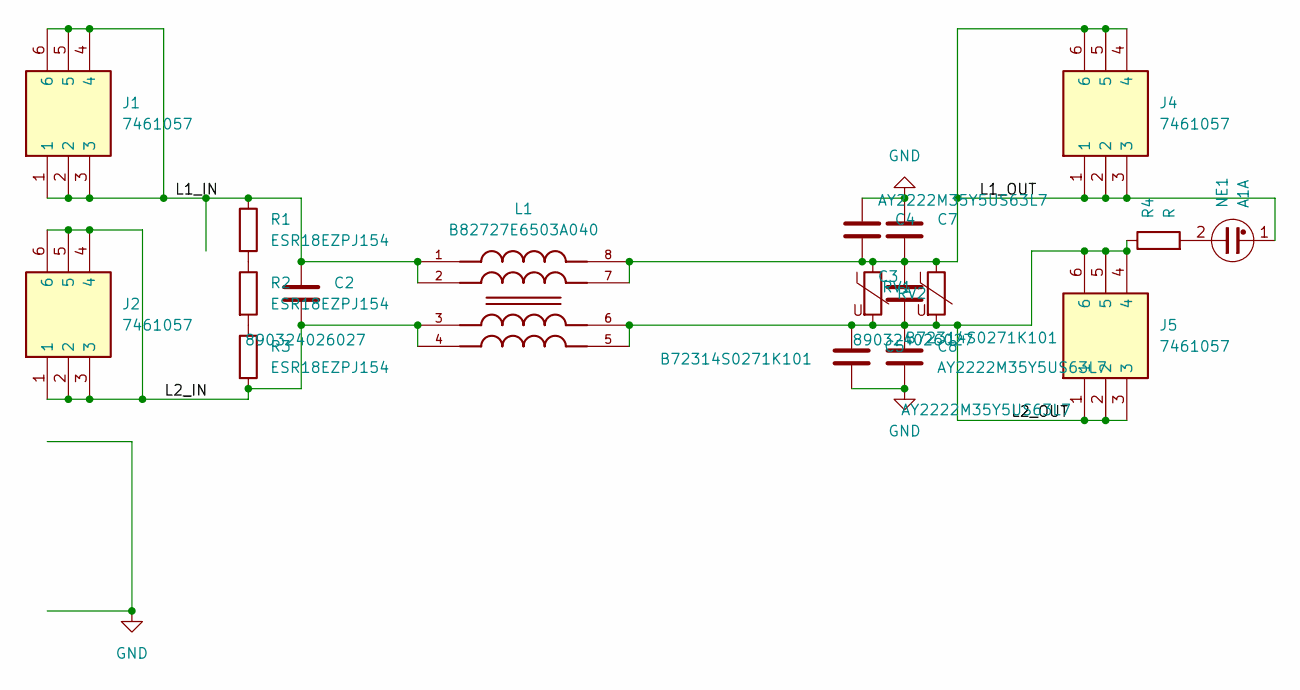
[picture p24: schematic booster-emi-filter.kicad_sch]

Parts:
C2, C3: 890324026027
C4, C5, C7, C8: AY2222M35Y5US63L7
J1, J2, J4, J5: 7461057; Mouser Part Number 710-7461057
L1: B82727E6503A040; IND_B82727E6503A040; PARTREV May 2015
NE1: A1A; NEON-A1A
R1, R2, R3: ESR18EZPJ154; R_1206_3216Metric_Pad1.30x1.75mm_HandSolder
R4: R; R_Axial_DIN0207_L6.3mm_D2.5mm_P7.62mm_Horizontal
RV1, RV2: B72314S0271K101

Connections:
/L1_IN: C2.1, J1.1, J1.2, J1.3, J1.4, J1.5, J1.6, L1.1, L1.2, R1.1
/L1_OUT: C3.1, C4.2, C7.2, J4.1, J4.2, J4.3, J4.4, J4.5, J4.6, L1.7, L1.8, NE1.1, RV1.1, RV2.1
/L2_IN: C2.2, J2.1, J2.2, J2.3, J2.4, J2.5, J2.6, L1.3, L1.4, R3.2
/L2_OUT: C3.2, C5.1, C8.1, J5.1, J5.2, J5.3, J5.4, J5.5, J5.6, L1.5, L1.6, R4.1, RV1.2, RV2.2
GND: C4.1, C5.2, C7.1, C8.2
unnamed: NE1.2, R4.2
unnamed: R1.2, R2.1
unnamed: R2.2, R3.1

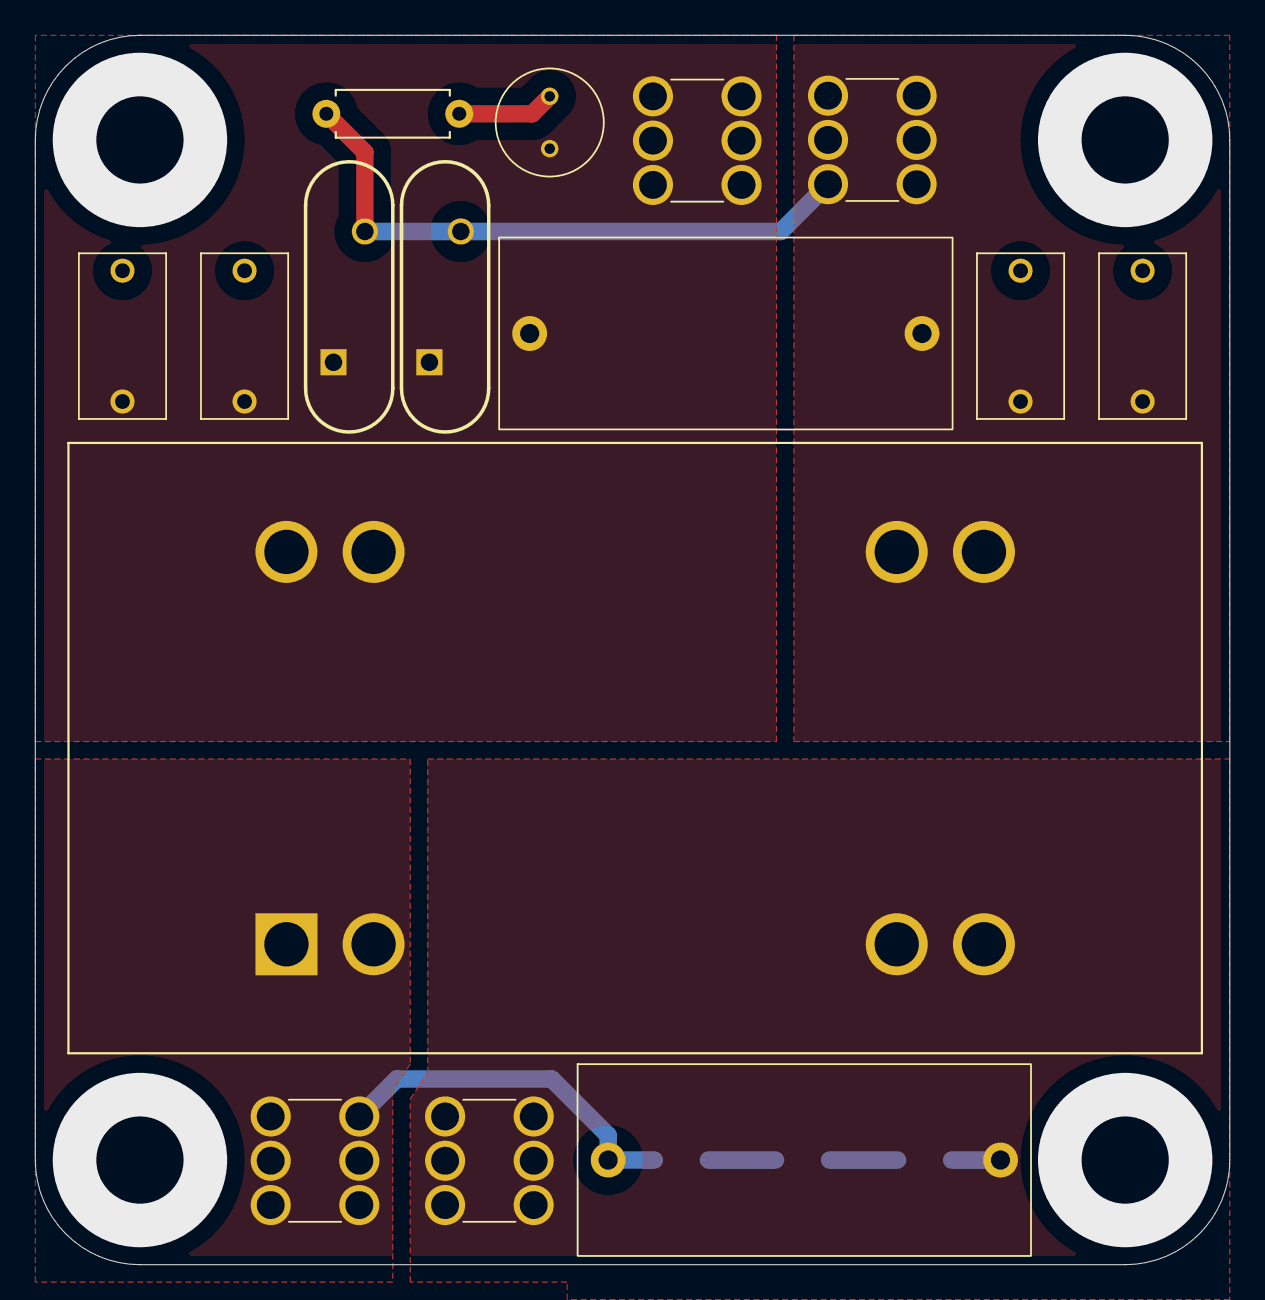
[picture p25: board booster-emi-filter.kicad_pcb from above]

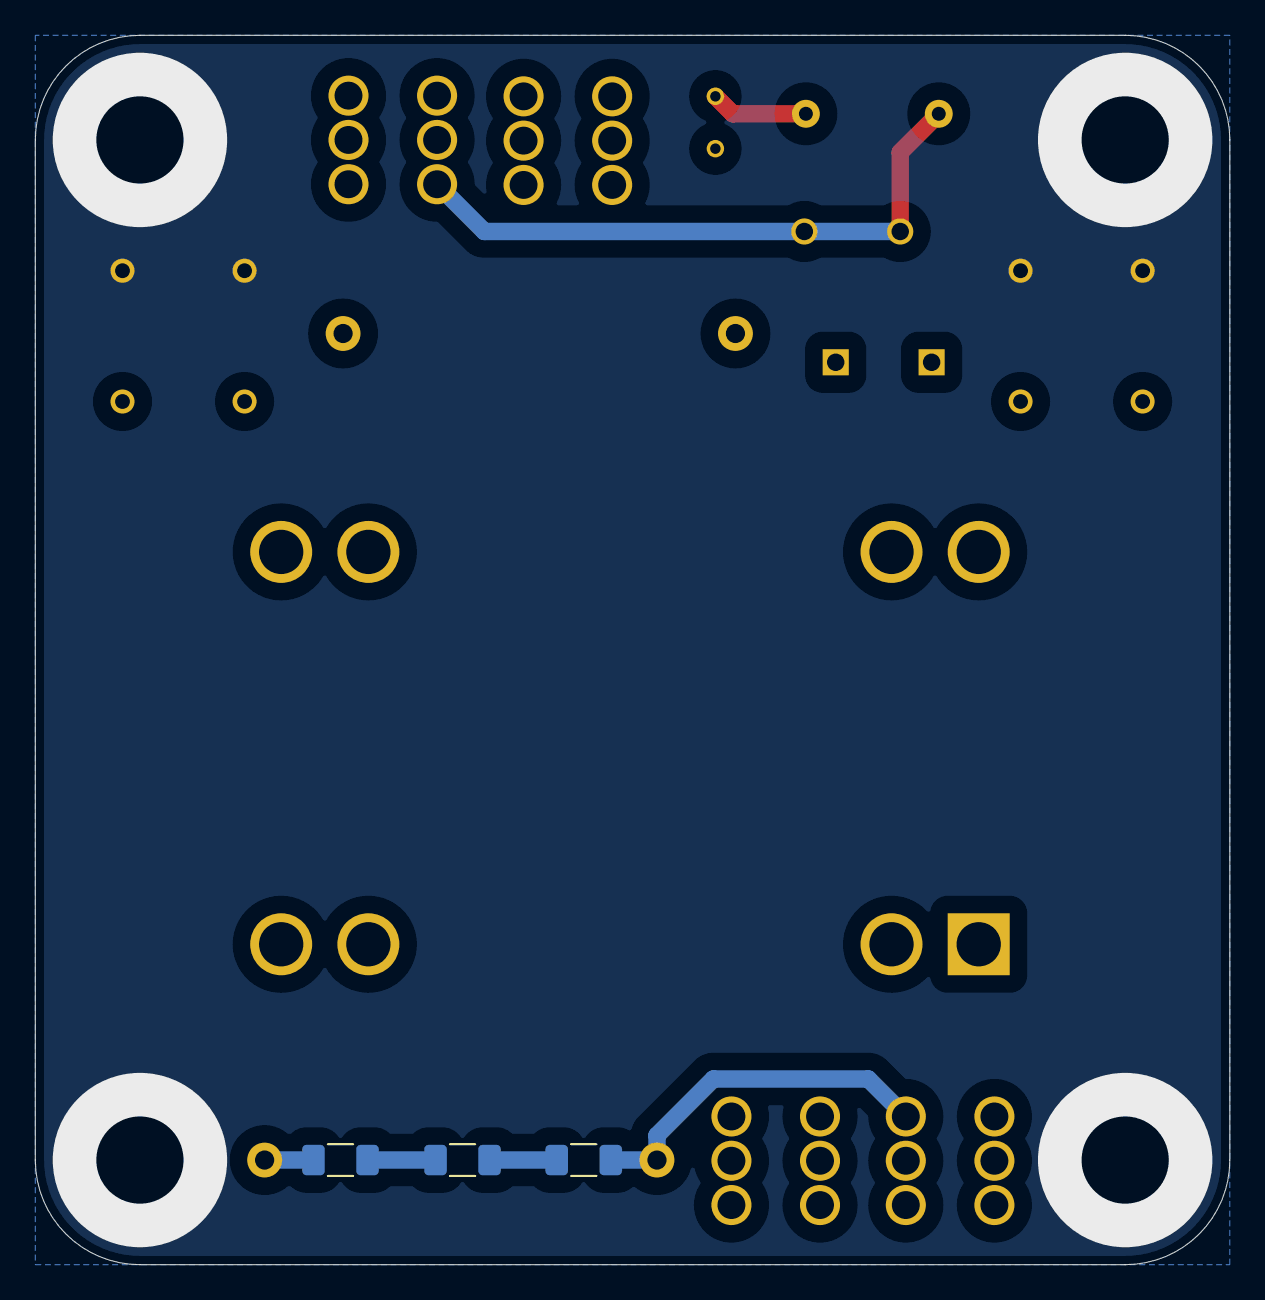
[picture p26: board booster-emi-filter.kicad_pcb from below]

Board: 2 copper layers, 68.5 x 70.5 mm, 18 parts (3 on the bottom side), 8 nets.
