flyingperson23/Booster-TC/software/Booster-TC.ioc

Mcu.UserName=STM32G474CBTx
PA0.GPIO_Label=I_PRI
PA0.Signal=COMP3_INP
PA1.GPIO_Label=CTP_1
PA1.Signal=COMP1_INP
PA12.GPIO_Label=MODE_IN
PA12.Signal=GPIO_Input
PA13.GPIO_Label=TMS
PA13.Signal=SYS_JTMS-SWDIO
PA14.GPIO_Label=TCK
PA14.Signal=SYS_JTCK-SWCLK
PA15.Signal=SYS_JTDI
PA2.GPIO_Label=THERM2
PA2.Signal=ADC1_IN3
PA3.GPIO_Label=THERM1
PA3.Signal=ADC1_IN4
PA4.GPIO_Label=CTM_1
PA4.Signal=COMP1_INM
PA5.GPIO_Label=INT
PA5.Signal=GPXTI5
PA6.GPIO_Label=LED_VBUS
PA6.Signal=S_TIM3_CH1
PA7.GPIO_Label=LED_TEMP
PA7.Signal=S_TIM3_CH2
PA8.GPIO_Label=VBUS_SENSE
PA8.Signal=ADC5_IN1
PA9.GPIO_Label=PFC
PA9.Signal=HRTIM1_CHA2
PB0.GPIO_Label=LED_I_IN
PB0.Signal=S_TIM3_CH3
PB1.GPIO_Label=V24_NI
PB1.Signal=ADC3_IN1
PB10.Signal=USART3_TX
PB11.GPIO_Label=VAC_SENSE
PB11.Signal=SharedAnalog_PB11
PB12.GPIO_Label=THERM_BOARD
PB12.Signal=ADC1_IN11
PB13.GPIO_Label=FAN_EN
PB13.Signal=GPIO_Output
PB14.GPIO_Label=I_L
PB14.Signal=SharedAnalog_PB14
PB15.GPIO_Label=FAN_PWM
PB15.Signal=S_TIM15_CH2
PB2.GPIO_Label=SCR
PB2.Signal=S_TIM20_CH1
PB3.Signal=SYS_JTDO-SWO
PB4.Signal=SYS_JTRST
PB5.GPIO_Label=GDT_B
PB5.Signal=TIM8_CH3N
PB6.GPIO_Label=GDT2_DIS
PB6.Signal=GPIO_Output
PB7.GPIO_Label=GDT1_DIS
PB7.Signal=GPIO_Output
PB8-BOOT0.Signal=USART3_RX
PB9.GPIO_Label=GDT_A
PB9.Signal=S_TIM8_CH3
PF0-OSC_IN.Signal=RCC_OSC_IN
PF1-OSC_OUT.Signal=RCC_OSC_OUT
