flyingperson23/Booster-TC/software/Core/Inc/main.h

#define I_PRI_Pin GPIO_PIN_0
#define I_PRI_GPIO_Port GPIOA
#define CTP_1_Pin GPIO_PIN_1
#define CTP_1_GPIO_Port GPIOA
#define THERM2_Pin GPIO_PIN_2
#define THERM2_GPIO_Port GPIOA
#define THERM1_Pin GPIO_PIN_3
#define THERM1_GPIO_Port GPIOA
#define CTM_1_Pin GPIO_PIN_4
#define CTM_1_GPIO_Port GPIOA
#define INT_Pin GPIO_PIN_5
#define INT_GPIO_Port GPIOA
#define INT_EXTI_IRQn EXTI9_5_IRQn
#define LED_VBUS_Pin GPIO_PIN_6
#define LED_VBUS_GPIO_Port GPIOA
#define LED_TEMP_Pin GPIO_PIN_7
#define LED_TEMP_GPIO_Port GPIOA
#define LED_I_IN_Pin GPIO_PIN_0
#define LED_I_IN_GPIO_Port GPIOB
#define V24_NI_Pin GPIO_PIN_1
#define V24_NI_GPIO_Port GPIOB
#define SCR_Pin GPIO_PIN_2
#define SCR_GPIO_Port GPIOB
#define VAC_SENSE_Pin GPIO_PIN_11
#define VAC_SENSE_GPIO_Port GPIOB
#define THERM_BOARD_Pin GPIO_PIN_12
#define THERM_BOARD_GPIO_Port GPIOB
#define FAN_EN_Pin GPIO_PIN_13
#define FAN_EN_GPIO_Port GPIOB
#define I_L_Pin GPIO_PIN_14
#define I_L_GPIO_Port GPIOB
#define FAN_PWM_Pin GPIO_PIN_15
#define FAN_PWM_GPIO_Port GPIOB
#define VBUS_SENSE_Pin GPIO_PIN_8
#define VBUS_SENSE_GPIO_Port GPIOA
#define PFC_Pin GPIO_PIN_9
#define PFC_GPIO_Port GPIOA
#define MODE_IN_Pin GPIO_PIN_12
#define MODE_IN_GPIO_Port GPIOA
#define TMS_Pin GPIO_PIN_13
#define TMS_GPIO_Port GPIOA
#define TCK_Pin GPIO_PIN_14
#define TCK_GPIO_Port GPIOA
#define GDT_B_Pin GPIO_PIN_5
#define GDT_B_GPIO_Port GPIOB
#define GDT2_DIS_Pin GPIO_PIN_6
#define GDT2_DIS_GPIO_Port GPIOB
#define GDT1_DIS_Pin GPIO_PIN_7
#define GDT1_DIS_GPIO_Port GPIOB
#define GDT_A_Pin GPIO_PIN_9
#define GDT_A_GPIO_Port GPIOB
