flyingperson23/Booster-TC/software/Core/Src/sys/tterm/TTerm_cmd.c

/*
 * TTerm
 *
 * Copyright (c) 2020 Thorben Zethoff
 *
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
 * THE SOFTWARE IS PROVIDED "AS IS", WITHOUT WARRANTY OF ANY KIND, EXPRESS OR
 * IMPLIED, INCLUDING BUT NOT LIMITED TO THE WARRANTIES OF MERCHANTABILITY, FITNESS
 * FOR A PARTICULAR PURPOSE AND NONINFRINGEMENT. IN NO EVENT SHALL THE AUTHORS OR
 * COPYRIGHT HOLDERS BE LIABLE FOR ANY CLAIM, DAMAGES OR OTHER LIABILITY, WHETHER
 * IN AN ACTION OF CONTRACT, TORT OR OTHERWISE, ARISING FROM, OUT OF OR IN
 * CONNECTION WITH THE SOFTWARE OR THE USE OR OTHER DEALINGS IN THE SOFTWARE.
*/

#if PIC32 == 1
#include <xc.h>
#endif  
#include <stdint.h>
#include <string.h>
#include <stdarg.h>
#include <stdlib.h>

#include "sys/tterm/TTerm.h"
#include "sys/tterm/TTerm_config.h"
#include "sys/tterm/TTerm_cmd.h"

#if __has_include("util.h")
    #include "util.h"
#endif

//#include "system.h"
//#include "UART.h"

AC_LIST_HEAD * head;

uint8_t CMD_testCommandHandler(TERMINAL_HANDLE * handle, uint8_t argCount, char ** args){
    uint8_t currArg = 0;
    uint8_t returnCode = 0;
    for(;currArg<argCount; currArg++){
        if(strcmp(args[currArg], "-?") == 0){
            ttprintf("This function is intended for testing. it will list all passed arguments\r\n");
            ttprintf("usage:\r\n\ttest [{option} {value}]\r\n\n\t-aa : adds an argument to the ACL\r\n\n\t-ra : removes an argument from the ACL\r\n\n\t-r  : returns with the given code");
            return TERM_CMD_EXIT_SUCCESS;
        }else if(strcmp(args[currArg], "-r") == 0){
            if(argCount > currArg + 1){
                returnCode = atoi(args[currArg + 1]);
                ttprintf("returning %d (from string \"%s\")\r\n", returnCode, args[currArg + 1]);
                currArg++;
                return returnCode;
            }else{
                ttprintf("usage:\r\ntest -r [return code]\r\n");
                return 0;
            }
#if __has_include("util.h") && __has_include("ff.h")
        }else if(strcmp(args[currArg], "-c") == 0){
            if(argCount > currArg + 1){
                ttprintf("searching for \"%s\" in file \"config.cfg\"\r\n", args[currArg + 1]);
                
                //open file
                FIL* log = f_open("/config.cfg", FA_READ);
                if(log < 0xff){
                    //file open failed
                    ttprintf("file opening failed (%d)\r\n", log);
                    return TERM_CMD_EXIT_SUCCESS;
                }
                
                char * ret = CONFIG_getKey(log, args[currArg + 1]);
                if(ret == NULL){
                    ttprintf("key not found\r\n");
                }else{
                    ttprintf("key found with value=\"%s\"\r\n", ret);
                    vPortFree(ret);
                }
                
                return TERM_CMD_EXIT_SUCCESS;
            }else{
                ttprintf("usage:\r\ntest -c [key to search for]\r\n");
                return TERM_CMD_EXIT_ERROR;
            }
            
        }else if(strcmp(args[currArg], "-atoiFP") == 0){
            if(argCount > currArg + 2){
                int32_t exponent = atoi(args[currArg + 2]);
                ttprintf("converting \"%s\" to int with base exponent %d\r\n", args[currArg + 1], exponent);
                ttprintf("res=%d\r\n", atoiFP(args[currArg+1], 100, exponent, 1));
                
                return TERM_CMD_EXIT_SUCCESS;
            }else if(argCount > currArg + 1){
                ttprintf("converting \"%s\" to int with base exponent 0\r\n", args[currArg + 1]);
                ttprintf("res=%d\r\n", atoiFP(args[currArg+1], 100, 0, 1));
                
                return TERM_CMD_EXIT_SUCCESS;
            }else{
                ttprintf("usage:\r\ntest -atoiFP [value to convert]\r\n");
                return TERM_CMD_EXIT_ERROR;
            }
#endif
        }else if(strcmp(args[currArg], "-ra") == 0){
            if(++currArg < argCount){
                ACL_remove(head, args[currArg]);
                ttprintf("removed \"%s\" from the ACL\r\n", args[currArg]);
                returnCode = TERM_CMD_EXIT_SUCCESS;
            }else{
                ttprintf("missing ACL element value for option \"-ra\"\r\n");
                returnCode = TERM_CMD_EXIT_ERROR;
            }
        }else if(strcmp(args[currArg], "-lp") == 0){
            ttprintf("going to sleep, good night :) \r\n");
            //SYS_setOscillatorSource(0b001);
            //SYS_setOscillatorSource(0b101);
        }else if(strcmp(args[currArg], "-aa") == 0){
            if(++currArg < argCount){
                char * newString = malloc(strlen(args[currArg])+1);
                strcpy(newString, args[currArg]);
                ACL_add(head, newString);
                ttprintf("Added \"%s\" to the ACL\r\n", args[currArg]);
                returnCode = TERM_CMD_EXIT_SUCCESS;
            }else{
                ttprintf("missing ACL element value for option \"-aa\"\r\n");
                returnCode = TERM_CMD_EXIT_ERROR;
            }
#ifdef TERM_startTaskPerCommand
        }else if(strcmp(args[currArg], "-i") == 0){
            ttprintf("testing reading of input:\r\n");
            ttprintf("please enter your name:"); 
            char * name = ttgetline(portMAX_DELAY);
            ttprintf(" ok!\r\n");
            ttprintf("Hello %s :)\r\n", name);
            free(name);
            returnCode = TERM_CMD_EXIT_SUCCESS;
        }else if(strcmp(args[currArg], "-iI") == 0){
            uint32_t chip = 0;
            ttprintf("What is the number of the SID Chip the C64 (MOSxxxx)?\r\n>"); 
            while(1){
                char * id = ttgetline(portMAX_DELAY);
                ttprintf("\r\n");
                chip = atoi(id);
                free(id);
                if(chip == 6581 || chip == 8580 || chip == 42){
                    break;
                }else{
                    ttprintf("wrooong, try again\r\n>");
                }
            }
            
            if(chip == 42) {
                ttprintf("damn it... its wrong but of course 42 is a solution to the question... bugger off\r\n");
            } else{
                ttprintf("correct! you may now leave :D\r\n");
            }
            
            returnCode = TERM_CMD_EXIT_SUCCESS;
#endif
        }
    }
    if(returnCode != 0) return returnCode;
    
    ttprintf("Terminal test function called. ArgCount = %d ; Calling user = \"%s\"%s\r\n", argCount, handle->currUserName, (argCount != 0) ? "; \r\narguments={" : "");
    for(currArg = 0;currArg<argCount; currArg++){
        ttprintf("%d:\"%s\"%s\r\n", currArg, args[currArg], (currArg == argCount - 1) ? "\r\n}" : ",");
    }
    return TERM_CMD_EXIT_SUCCESS;
}

uint8_t TERM_testCommandAutoCompleter(TERMINAL_HANDLE * handle, void * params){
    if(params == 0){ 
        handle->autocompleteBufferLength = 0;
        return 0;
    }
    
    AC_LIST_HEAD * list = (AC_LIST_HEAD *) params;
    
    if(list->elementCount == 0){ 
        handle->autocompleteBufferLength = 0;
        return 0;
    }
    
    char * buff = malloc(128);
    uint8_t len;
    memset(buff, 0, 128);
    handle->autocompleteStart = TERM_findLastArg(handle, buff, &len);
    
    //TODO use a reasonable size here
    handle->autocompleteBuffer = malloc(list->elementCount * sizeof(char *));
    handle->currAutocompleteCount = 0;
    handle->autocompleteBufferLength = TERM_doListAC(list, buff, len, handle->autocompleteBuffer);

    //UART_print("\r\ncompleting \"%s\" (len = %d, matching = %d) will delete until %d\r\n", buff, len, handle->autocompleteBufferLength, handle->autocompleteStart);
        
    free(buff);
    return handle->autocompleteBufferLength;
}

#ifdef TERM_RESET_FUNCTION
uint8_t CMD_reset(TERMINAL_HANDLE * handle, uint8_t argCount, char ** args){
    TERM_RESET_FUNCTION();
    return TERM_CMD_EXIT_SUCCESS;
}
#endif

uint8_t CMD_help(TERMINAL_HANDLE * handle, uint8_t argCount, char ** args){
    uint8_t currArg = 0;
    //uint8_t returnCode = TERM_CMD_EXIT_SUCCESS;
    for(;currArg<argCount; currArg++){
        if(strcmp(args[currArg], "-?") == 0){
            ttprintf("come on do you really need help with help?\r\n");
            return TERM_CMD_EXIT_SUCCESS;
        }
    }
    ttprintf("\r\nTTerm %s\r\n%d Commands available:\r\n\r\n", TERM_VERSION_STRING, handle->cmdListHead->commandLength);
    ttprintf("\x1b[%dC%s\r\x1b[%dC%s\r\n\r\n", 2, "Command:", 19, "Description:");
    TermCommandDescriptor * currCmd = handle->cmdListHead->nextCmd;
    while(currCmd != 0){
        ttprintf("\x1b[%dC%s\r\x1b[%dC%s\r\n", 3, currCmd->command, 20, currCmd->commandDescription);
        currCmd = currCmd->nextCmd;
    }
    return TERM_CMD_EXIT_SUCCESS;
}

uint8_t CMD_cls(TERMINAL_HANDLE * handle, uint8_t argCount, char ** args){
    uint8_t currArg = 0;
    //uint8_t returnCode = TERM_CMD_EXIT_SUCCESS;
    for(;currArg<argCount; currArg++){
        if(strcmp(args[currArg], "-?") == 0){
            ttprintf("clears the screen\r\n");
            return TERM_CMD_EXIT_SUCCESS;
        }
    }
    
    TERM_sendVT100Code(handle, _VT100_RESET, 0); TERM_sendVT100Code(handle, _VT100_CURSOR_POS1, 0);
    TERM_printBootMessage(handle);
    
    return TERM_CMD_EXIT_SUCCESS;
}
