flyingperson23/Booster-TC/software/Core/Inc/booster_tc.h

/*
 * booster_tc.h
 *
 *  Created on: Jul 9, 2024
 *      Author: flyin
 */

#ifndef INC_BOOSTER_TC_H_
#define INC_BOOSTER_TC_H_

#include <stdint.h>
#include <math.h>
#include "main.h"
#include "power/boost.h"
#include "power/scr.h"
#include "power/buck.h"
#include "power/pwm.h"
#include "sys/vars.h"
#include "sys/cmds.h"
#include "sys/uart.h"
#include "sys/util.h"
#include "status/fault.h"

void booster_init();
void booster_loop();
void background_loop();

void stop();

// power input
extern uint8_t power_state;
#define STATE_OFF 0
#define STATE_SCR 1
#define STATE_BOOST 2

extern uint8_t mode;
#define MODE_AUTO 0
#define MODE_MANUAL 1

extern float temps[3];
extern float V24_sense;
extern uint32_t vrefint_adc;

extern StructAvg VAC_avg;
extern StructAvg IAC_avg;
extern StructAvg VBUS_avg;

void DMATransferComplete_adc1(DMA_HandleTypeDef *_hdma);

#endif /* INC_BOOSTER_TC_H_ */
