flyingperson23/Booster-TC/(commit log)

2024-07-02 add hw
    [booster-I-board-B_Cu.gbr, booster-I-board-B_Mask.gbr, booster-I-board-B_Paste.gbr, booster-I-board-B_Silkscreen.gbr, booster-I-board-Edge_Cuts.gbr, booster-I-board-F_Cu.gbr, booster-I-board-F_Mask.gbr, booster-I-board-F_Paste.gbr]
2024-07-02 pin assignments
    [booster-tc-driver.kicad_pcb, booster-tc-driver.kicad_sch]
2024-07-08 driver pcb
    [booster-tc-driver-gatedrive.kicad_sch, booster-tc-driver-led.kicad_sch, booster-tc-driver.kicad_pcb, booster-tc-driver.kicad_sch]
2024-07-12 driver board+code
    [booster-tc-driver-B_Cu.gbr, booster-tc-driver-B_Mask.gbr, booster-tc-driver-B_Paste.gbr, booster-tc-driver-B_Silkscreen.gbr, booster-tc-driver-Edge_Cuts.gbr, booster-tc-driver-F_Cu.gbr, booster-tc-driver-F_Mask.gbr, booster-tc-driver-F_Paste.gbr]
2024-07-12 driver board work
    [booster-tc-driver.csv, booster-tc-driver.kicad_pcb, booster-tc-driver.kicad_sch]
2024-07-15 silkscreen + software cleanup
    [booster-tc-driver.kicad_pcb, booster-tc-driver.kicad_sch]
2024-07-15 schematic cleanup
    [booster-tc-driver-gatedrive.kicad_sch, booster-tc-driver.kicad_pcb, booster-tc-driver.kicad_sch, power.kicad_sch]
2024-07-19 changed pin assignments, improved hardware
    [booster-tc-driver-gatedrive.kicad_sch, booster-tc-driver.kicad_pcb, booster-tc-driver.kicad_sch]
2024-07-31 ftdi board + random stuff
    [booster-I-board-B_Cu.gbr, booster-I-board-B_Mask.gbr, booster-I-board-B_Paste.gbr, booster-I-board-B_Silkscreen.gbr, booster-I-board-Edge_Cuts.gbr, booster-I-board-F_Cu.gbr, booster-I-board-F_Mask.gbr, booster-I-board-F_Paste.gbr]
2024-08-01 driver work
    [booster-ftdi-board.kicad_pcb, booster-ftdi-board.kicad_sch, booster-tc-driver.kicad_pcb, booster-tc-driver.kicad_sch]
2024-08-21 timing work
    [booster-tc-driver.kicad_pcb]
2024-09-24 v2 work
    [booster-ftdi-board-B_Cu.gbr, booster-ftdi-board-B_Mask.gbr, booster-ftdi-board-B_Paste.gbr, booster-ftdi-board-B_Silkscreen.gbr, booster-ftdi-board-Edge_Cuts.gbr, booster-ftdi-board-F_Cu.gbr, booster-ftdi-board-F_Mask.gbr, booster-ftdi-board-F_Paste.gbr]
2024-10-04 driver v2 work
    [booster-tc-driver.kicad_pcb, booster-tc-driver.kicad_sch]
2024-10-21 pcb work
    [booster-tc-driver-B_Cu.gbr, booster-tc-driver-B_Mask.gbr, booster-tc-driver-B_Paste.gbr, booster-tc-driver-B_Silkscreen.gbr, booster-tc-driver-Edge_Cuts.gbr, booster-tc-driver-F_Cu.gbr, booster-tc-driver-F_Mask.gbr, booster-tc-driver-F_Paste.gbr]
2024-10-21 start v3
    [booster-tc-driver-gatedrive.kicad_sch, booster-tc-driver.kicad_pcb, booster-tc-driver.kicad_sch, power.kicad_sch]
2024-10-24 v3 front silkscreen
    [booster-tc-driver.kicad_pcb, booster-tc-driver.kicad_sch]
2024-11-02 pfc v3
    [booster-tc-B_Cu.gbr, booster-tc-B_Mask.gbr, booster-tc-B_Paste.gbr, booster-tc-B_Silkscreen.gbr, booster-tc-Edge_Cuts.gbr, booster-tc-F_Cu.gbr, booster-tc-F_Mask.gbr, booster-tc-F_Paste.gbr]
2024-11-03 pfc v3 finalized
    [booster-tc-driver.kicad_pcb, booster-tc-driver.kicad_sch, booster-tc.kicad_pcb, booster-tc.kicad_sch]
